RHIT-steineca/Armold/readme.md

If you are reading this then congrats you pulled the repo :D

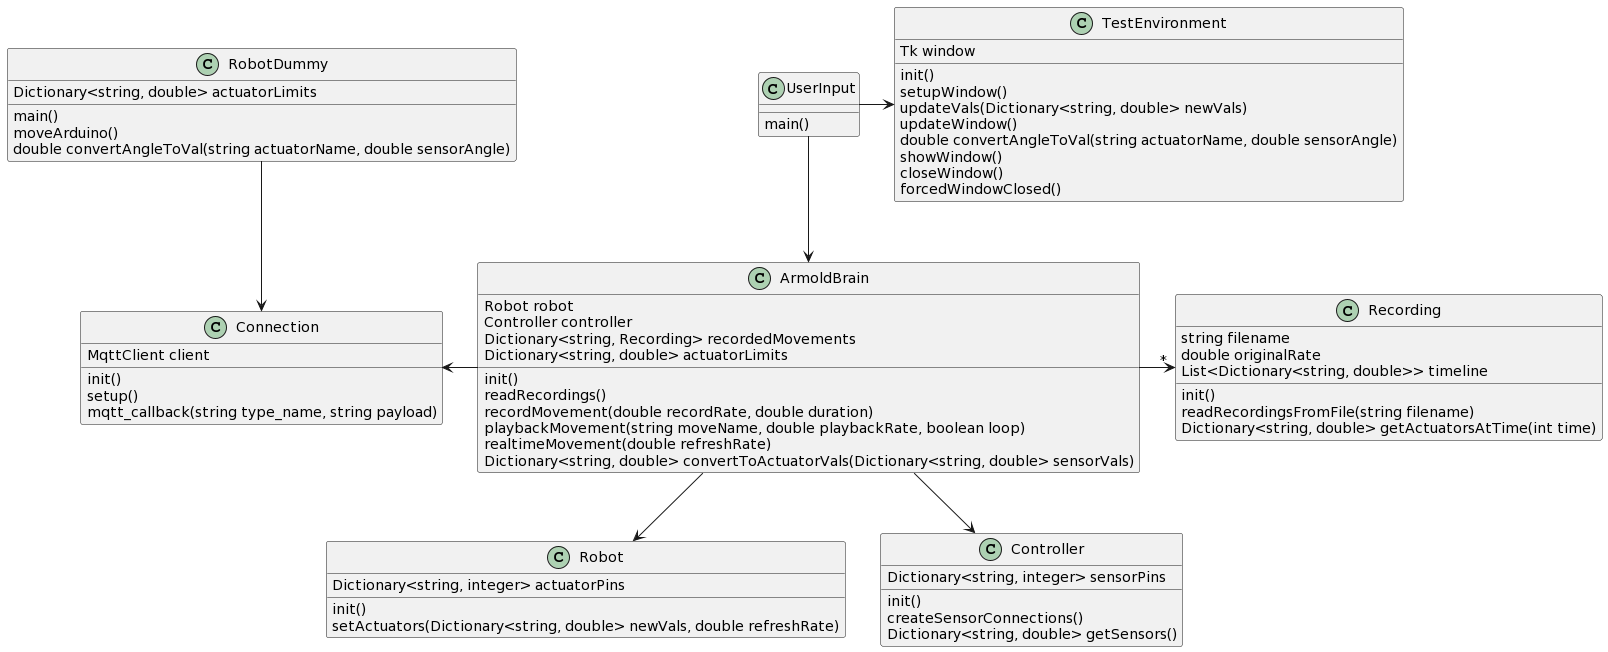
[picture p1: UML_diagram.png]
UML Diagram
