RHIT-steineca/Armold/Code_Files/pins.txt

Controller pins
{"shoulderCB":8,"shoulderLR":9,"elbow":10,"wrist":11,"fingerPTR":4,"fingerMDL":2,"fingerRNG":5,"fingerPKY":0,"fingerTHM":3,"shoulderR":12}
Robot pins
{"shoulderCB":12,"shoulderLR":13,"elbow":5,"wrist":6,"fingerPTR":11,"fingerMDL":10,"fingerRNG":8,"fingerPKY":7,"fingerTHM":9,"shoulderR":23}

NOTE: step direction pin is shoulderR - 1

full joint list for ez copying
{"shoulderCB":0,"shoulderLR":0,"elbow":0,"wrist":0,"fingerPTR":0,"fingerMDL":0,"fingerRNG":0,"fingerPKY":0,"fingerTHM":0,"shoulderR":0}
