RHIT-steineca/Armold/Important Documents/Current Budget.docx

Component | Max current draw (recorded) (A)
10K potentiometer | 0.077
Flex sensor | 0?
