RHIT-steineca/Armold/Important Documents/Servo Range of Motion.docx

Component | Restricted range | Max range | How much the part should move after the gears
Elbow | 0-235 | 0-270 | (18:12) 140 degrees
Pronation | 0-230 | 0-270 | (18:15) 180 degrees
Cross-body | 0-270 | 0-270 | (6:1) 45 degrees
Lateral | 0-270 | 0-270 | (3:1) 90 degrees
Stepper | 0-2400 | 0- | (12:1) 360 degrees
