RHIT-steineca/Armold/GearBox3DP0.png

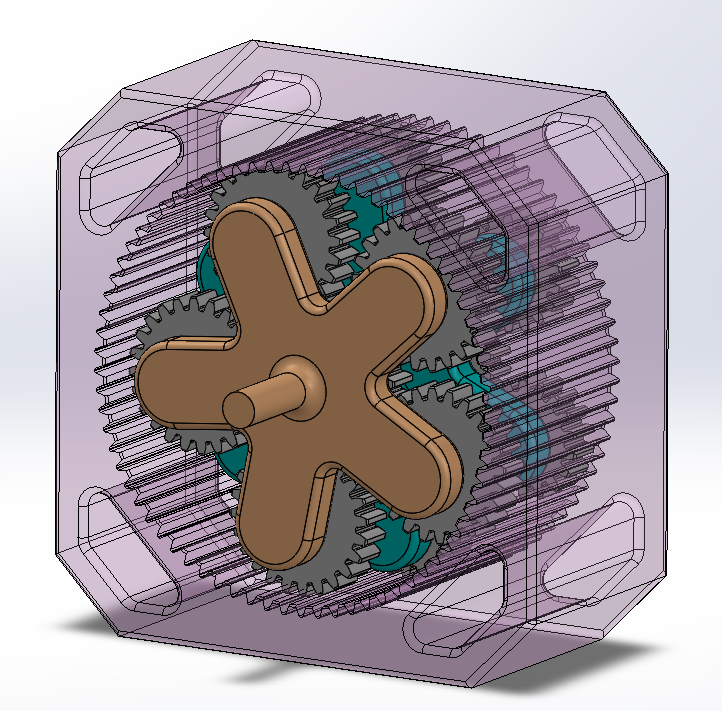
GearBox3DP0.png
