RHIT-steineca/Armold/Elbow and Pronation Solidworks/Elbow Assembly.SLDASM

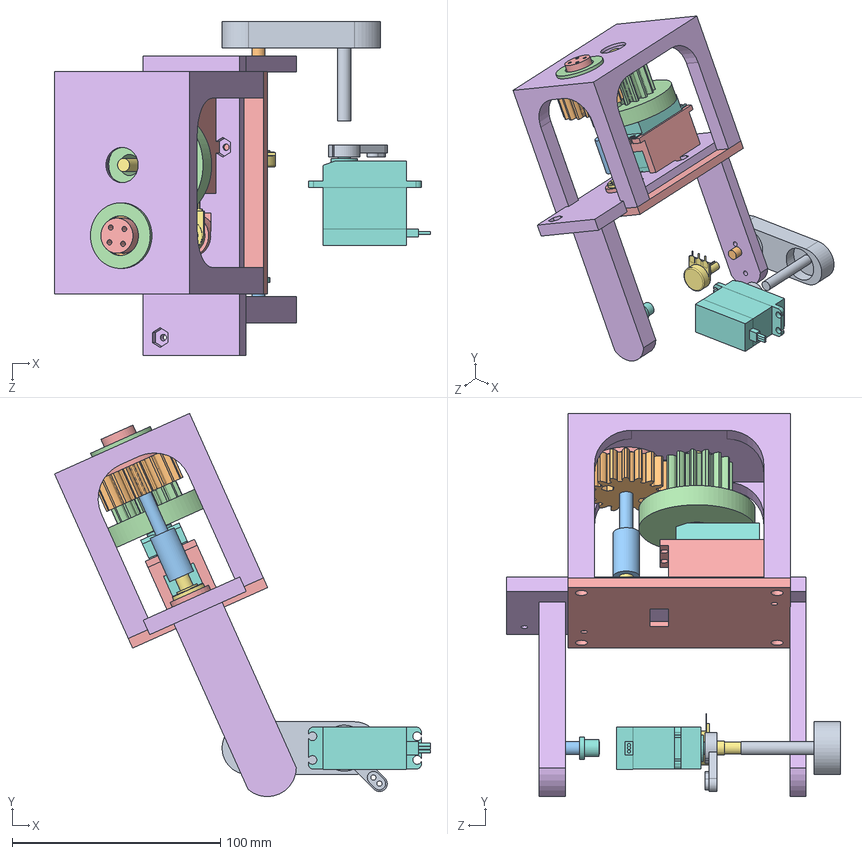
[picture p13: CAD file, 2024-05-17]
Elbow and Pronation Solidworks/Elbow Assembly.SLDASM
180.6 x 184.1 x 160.2 mm
B10K Potentiometer x 2
20KgServo x 2
20KgServoMetalElbow x 2
elbow to forearm connection
pronation base
24-15 Pronation Servo Gear
24-18 Pronation Potentiometer Gear
potentiometer to .25 stock
Needle Bearing x 2
bottom gear connection
Pronation top casing
Pronation Pot Stock
Pronation Servo Stock
Large Pronation Bearing
RodToBearingAdapter
Gear Connector
Elbow Servo stock
Elbow pronation stock
elbow rotation stock
