RHIT-steineca/Armold/Shared CAD/pronation top gears.SLDASM

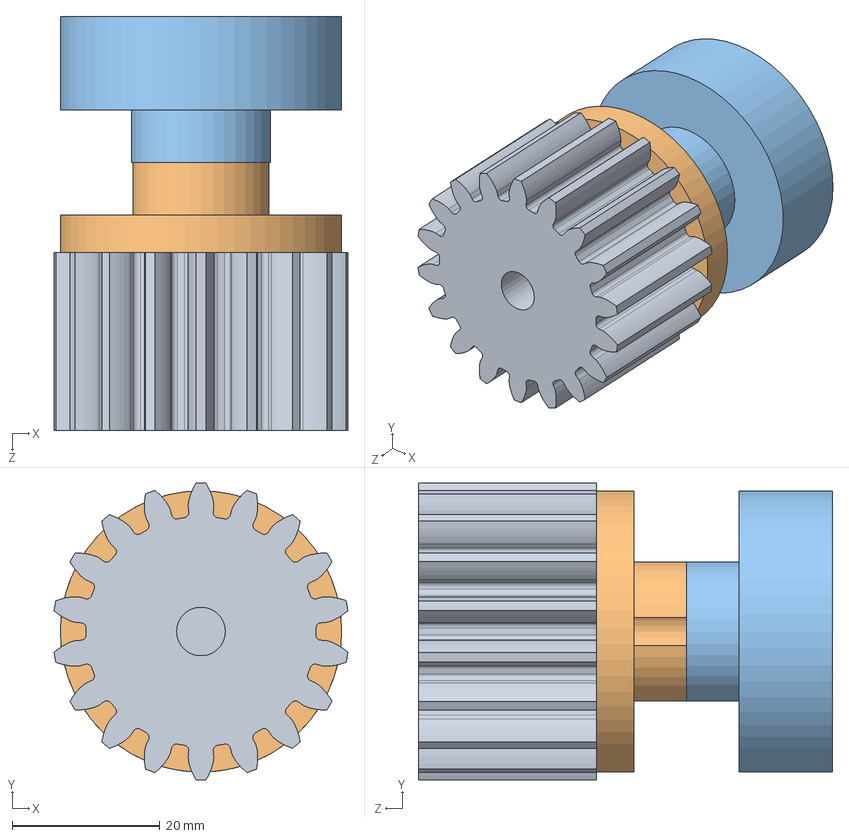
[picture p14: CAD file, 2024-01-10]
Shared CAD/pronation top gears.SLDASM
39.8 x 40.2 x 56.1 mm
24-18 Pronation Potentiometer Gear
bottom gear connection
top gear connection
