RHIT-steineca/Armold/Shared CAD/Elbow Assembly.SLDASM

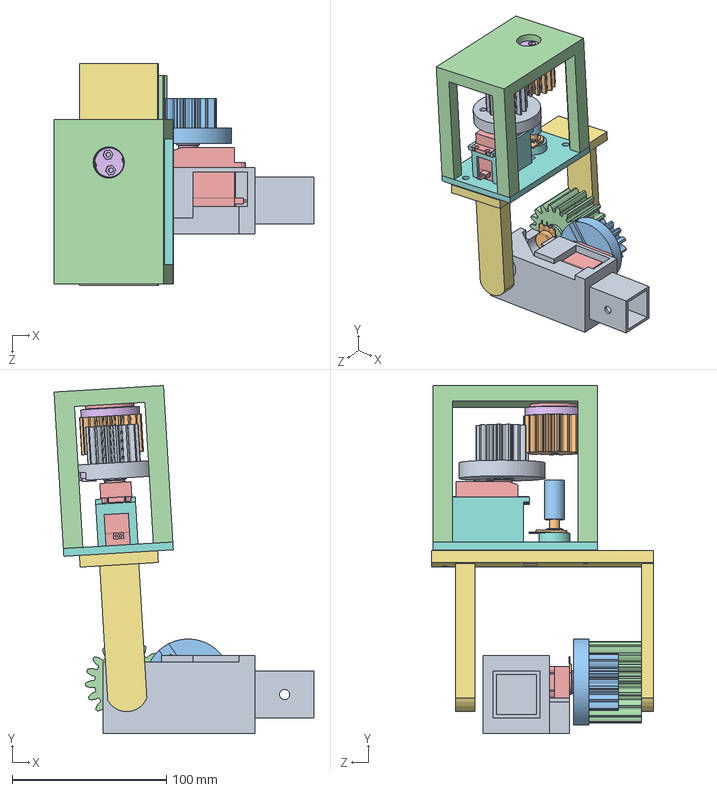
[picture p15: CAD file, 2024-01-10]
Shared CAD/Elbow Assembly.SLDASM
168.5 x 225.6 x 143.7 mm
ServoHolderElbow
B10K Potentiometer x 2
24 pitch 12 teeth 2.5x scale
24 pitch 18 teeth
20KgServo x 2
20KgServoMetalElbow x 2
elbow to forearm connection
pronation base
24-15 Pronation Servo Gear
24-18 Pronation Potentiometer Gear
potentiometer to .25 stock
Pronation top casing
Needle Bearing
bottom gear connection
