RHIT-steineca/Armold/Elbow and Pronation Solidworks/Pronation Assembly.SLDASM

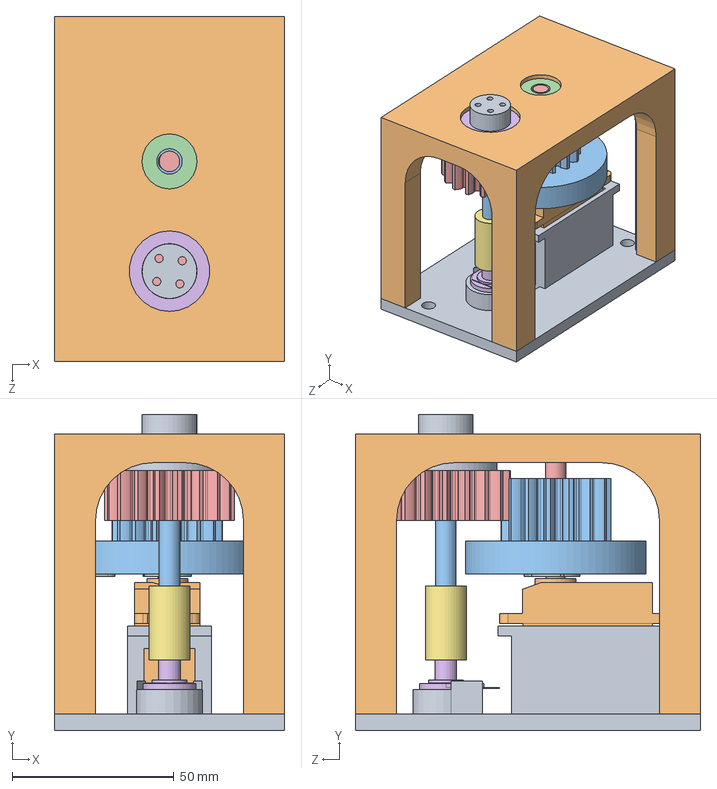
[picture p16: CAD file, 2024-03-17]
Elbow and Pronation Solidworks/Pronation Assembly.SLDASM
71.1 x 97.7 x 106.7 mm
pronation base
20KgServo
24-15 Pronation Servo Gear
20KgServoMetalElbow
24-18 Pronation Potentiometer Gear
B10K Potentiometer
potentiometer to .25 stock
Needle Bearing
bottom gear connection
Pronation top casing
Pronation Pot Stock
Basic Roller Bearing
Pronation Servo Stock
Large Pronation Bearing
