RHIT-steineca/Armold/Control Panel/perfboard holder.SLDPRT

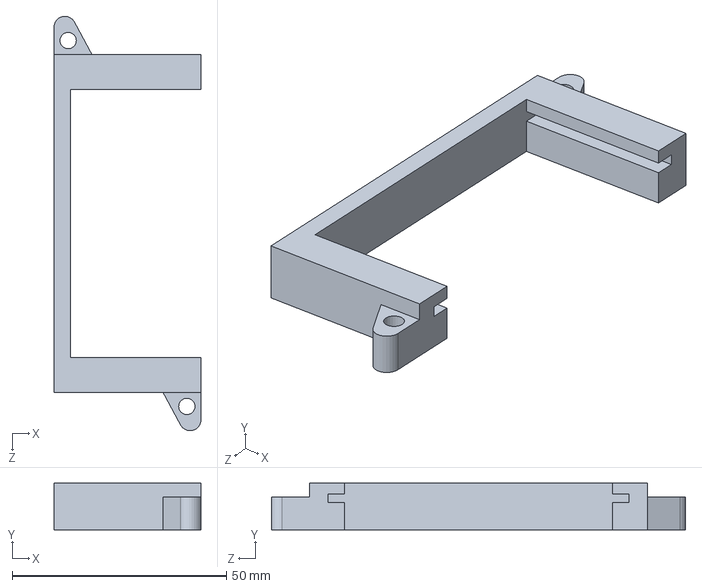
[picture p17: CAD file, 2024-05-18]
Control Panel/perfboard holder.SLDPRT
34.3 x 10.9 x 96.6 mm
