RHIT-steineca/Armold/Design_Files/Elbow Form 1.STL

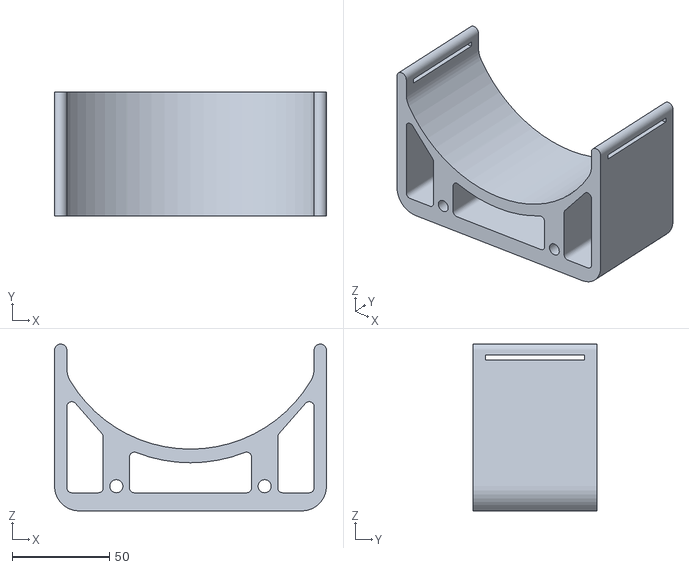
[picture p18: CAD file, 2023-09-13]
Design_Files/Elbow Form 1.STL
139.7 x 63.5 x 85.7
