RHIT-steineca/Armold/Hand and Forearm Solidworks/tensioner.SLDPRT

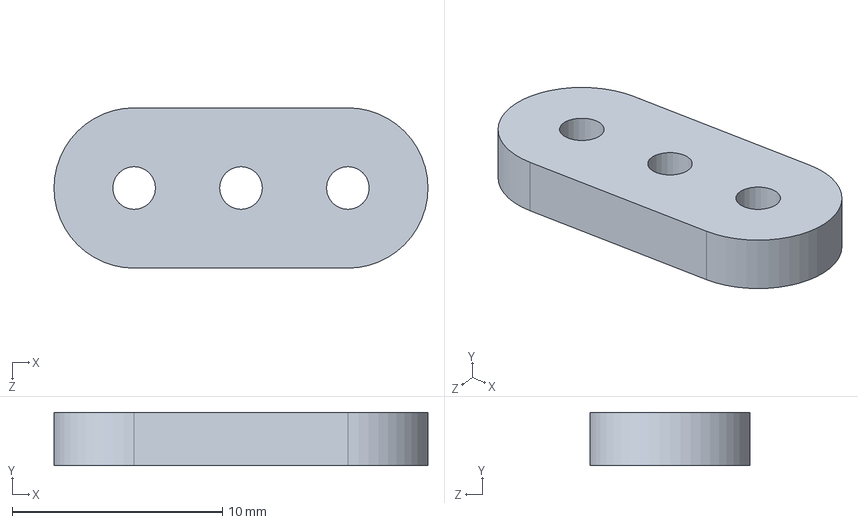
[picture p19: CAD file, 2024-05-18]
Hand and Forearm Solidworks/tensioner.SLDPRT
17.8 x 2.54 x 7.62 mm
