RHIT-steineca/Armold/Shared CAD/top gear connection.SLDPRT

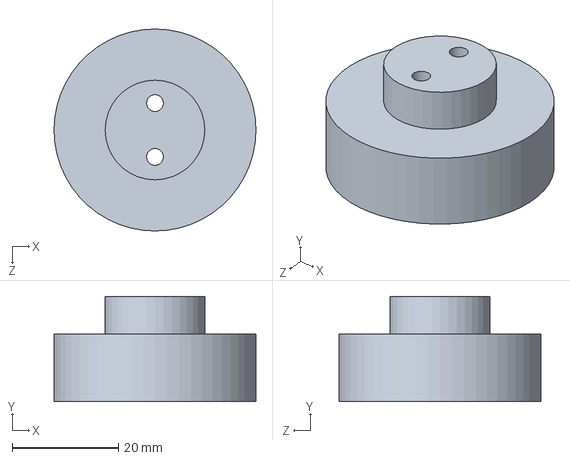
[picture p20: CAD file, 2024-05-18]
Shared CAD/top gear connection.SLDPRT
38.1 x 19.8 x 38.1 mm
