RHIT-steineca/Armold/Design_Files/Wrist Form 2.STL

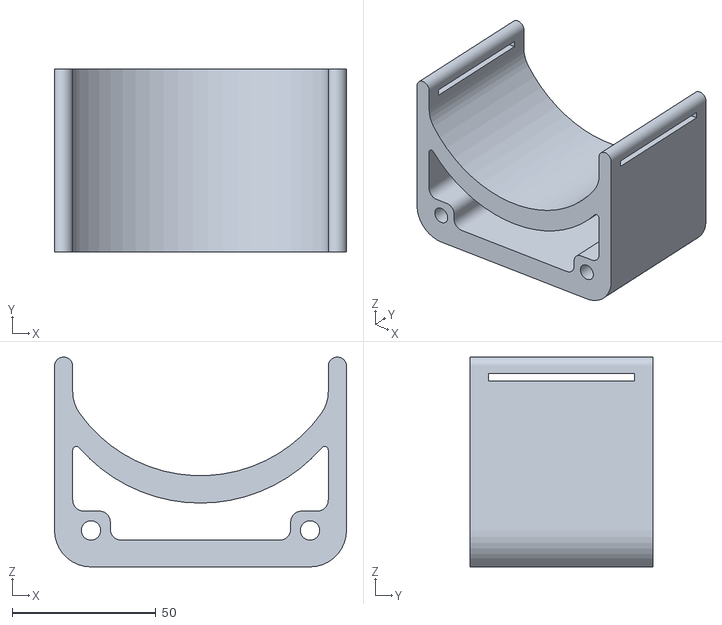
[picture p21: CAD file, 2023-09-13]
Design_Files/Wrist Form 2.STL
101.6 x 63.5 x 73.0
