RHIT-steineca/Armold/Hand and Forearm Solidworks/spool.SLDPRT

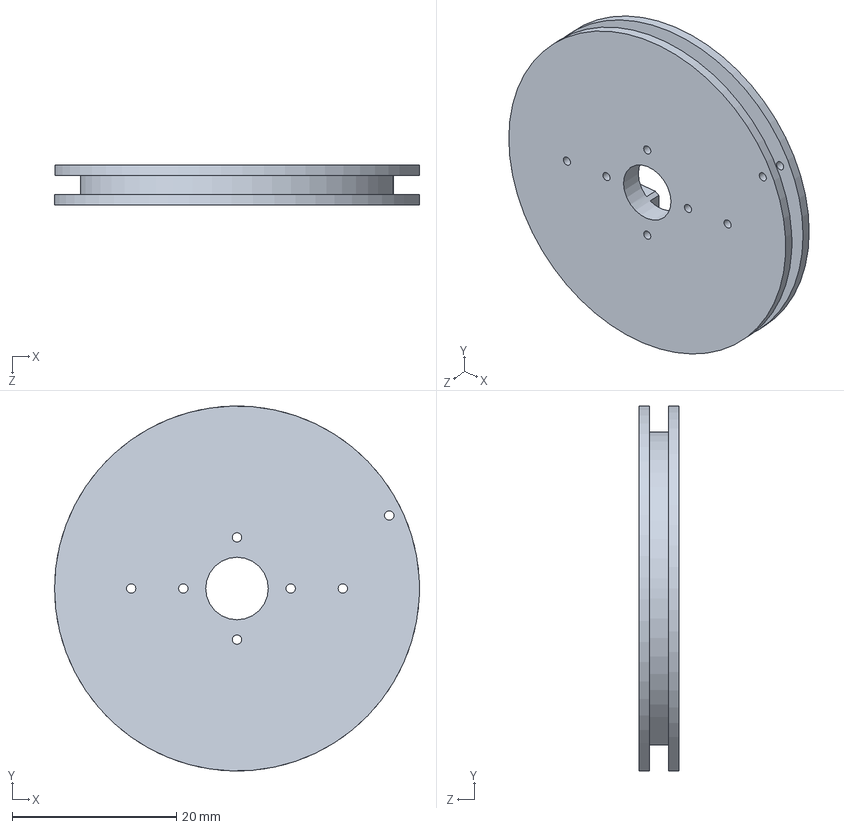
[picture p22: CAD file, 2024-05-18]
Hand and Forearm Solidworks/spool.SLDPRT
44.5 x 44.4 x 4.83 mm
