RHIT-steineca/Armold/Shared CAD/elbow to forearm connection.SLDPRT

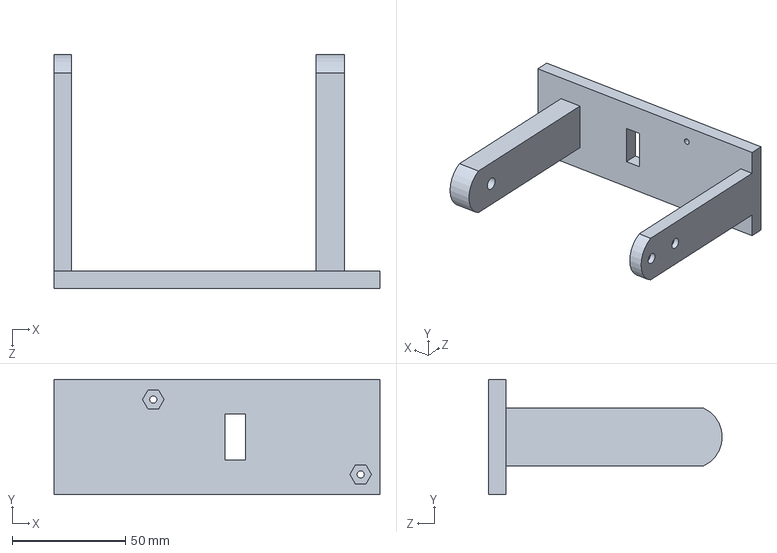
[picture p23: CAD file, 2024-01-10]
Shared CAD/elbow to forearm connection.SLDPRT
143.7 x 50.8 x 102.9 mm
