RHIT-steineca/Armold/Design_Files/Wrist Form 1.STL

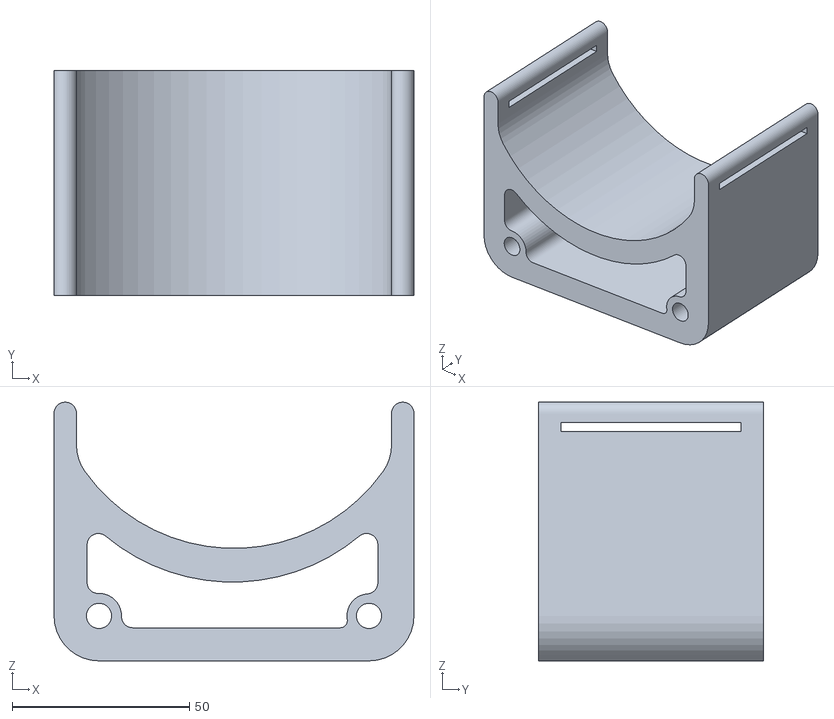
[picture p24: CAD file, 2023-09-13]
Design_Files/Wrist Form 1.STL
101.6 x 63.5 x 73.0
