RHIT-steineca/Armold/Elbow and Pronation Solidworks/elbow to forearm connection.SLDPRT

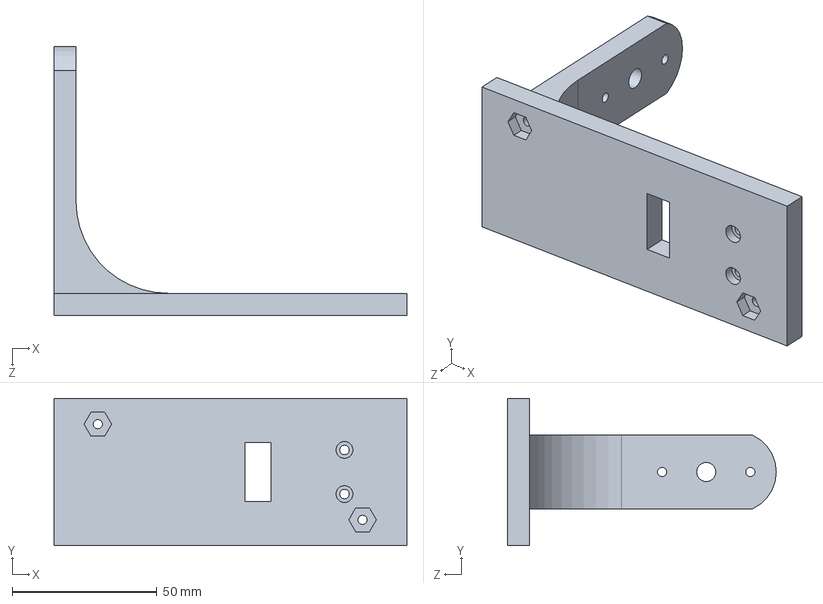
[picture p25: CAD file, 2024-03-17]
Elbow and Pronation Solidworks/elbow to forearm connection.SLDPRT
121.9 x 50.8 x 92.8 mm
