RHIT-steineca/Armold/Shared CAD/24 pitch 12 teeth 2.5x scale.SLDPRT

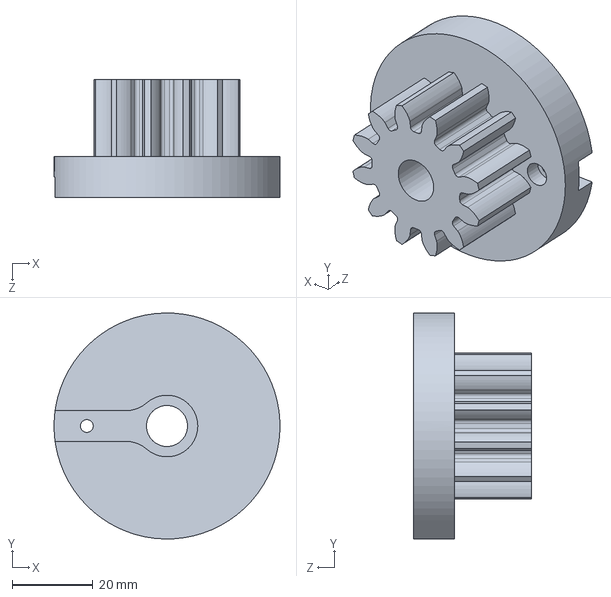
[picture p26: CAD file, 2024-01-10]
Shared CAD/24 pitch 12 teeth 2.5x scale.SLDPRT
55.9 x 55.9 x 29.2 mm
