RHIT-steineca/Armold/Elbow and Pronation Solidworks/upper arm stock.SLDPRT

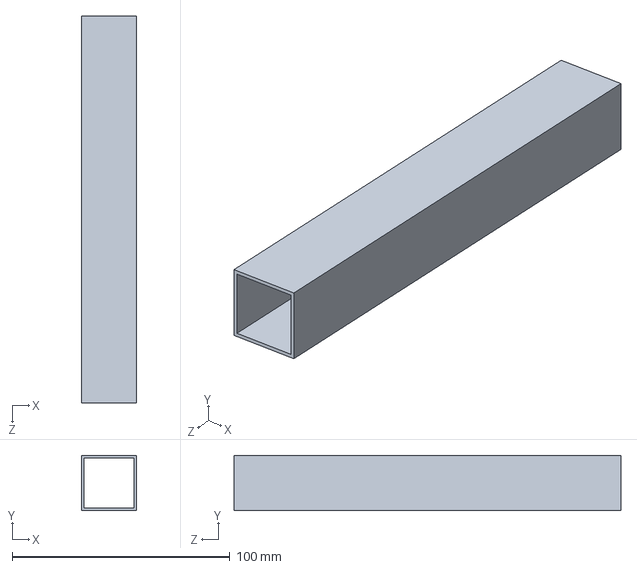
[picture p27: CAD file, 2024-03-17]
Elbow and Pronation Solidworks/upper arm stock.SLDPRT
25.4 x 25.4 x 177.8 mm
