RHIT-steineca/Armold/Shared CAD/24 pitch 18 teeth.SLDPRT

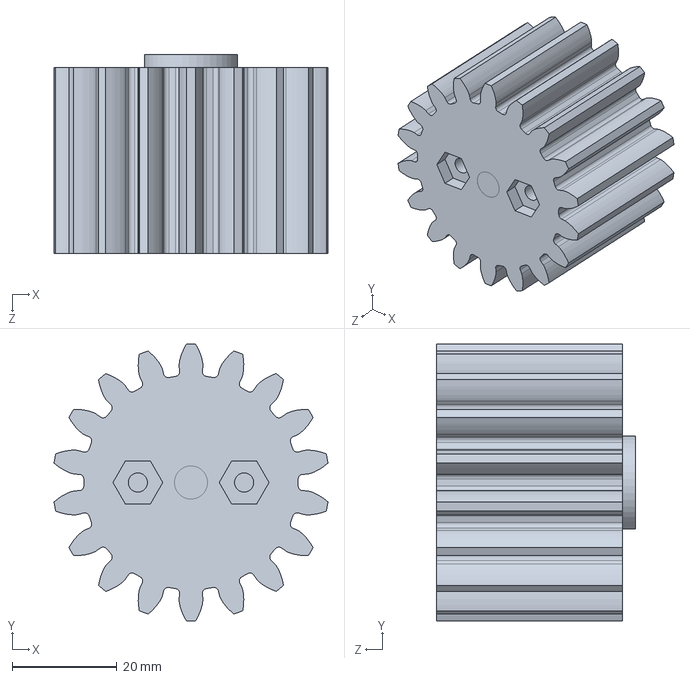
[picture p28: CAD file, 2024-01-10]
Shared CAD/24 pitch 18 teeth.SLDPRT
52.4 x 52.9 x 38.1 mm
