RHIT-steineca/Armold/Elbow and Pronation Solidworks/ServoHolder.SLDPRT

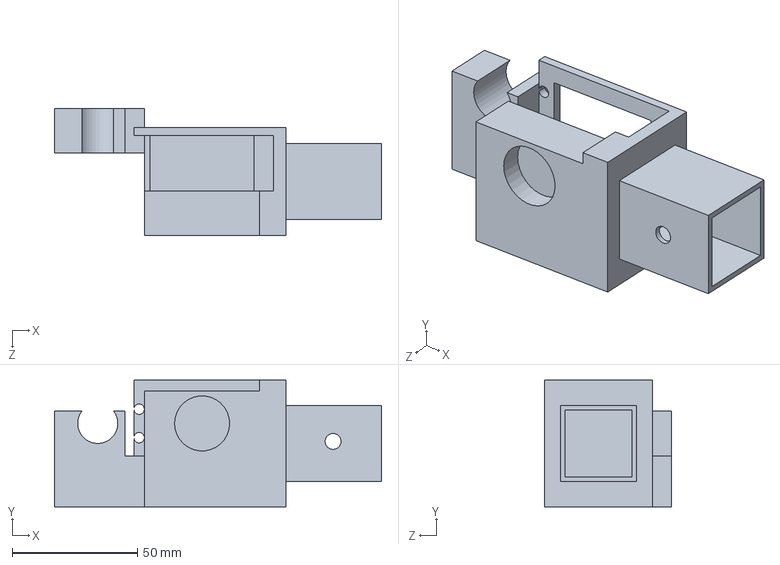
[picture p29: CAD file, 2024-03-17]
Elbow and Pronation Solidworks/ServoHolder.SLDPRT
130.6 x 50.5 x 50.8 mm
