RHIT-steineca/Armold/Shared CAD/bottom gear connection.SLDPRT

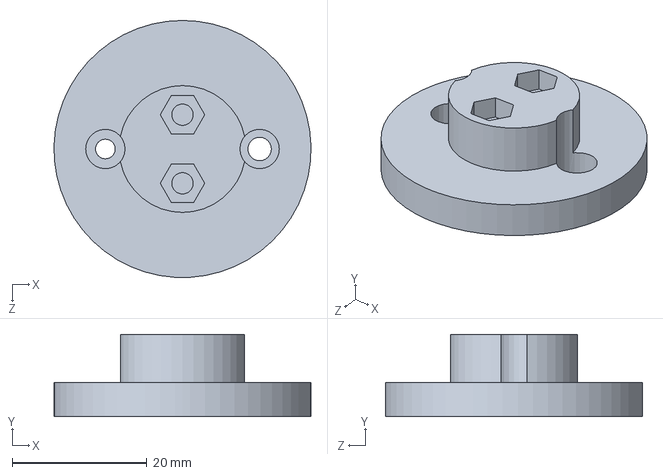
[picture p30: CAD file, 2024-01-10]
Shared CAD/bottom gear connection.SLDPRT
38.1 x 12.2 x 38.1 mm
