RHIT-steineca/Armold/Elbow and Pronation Solidworks/top gear connection.SLDPRT

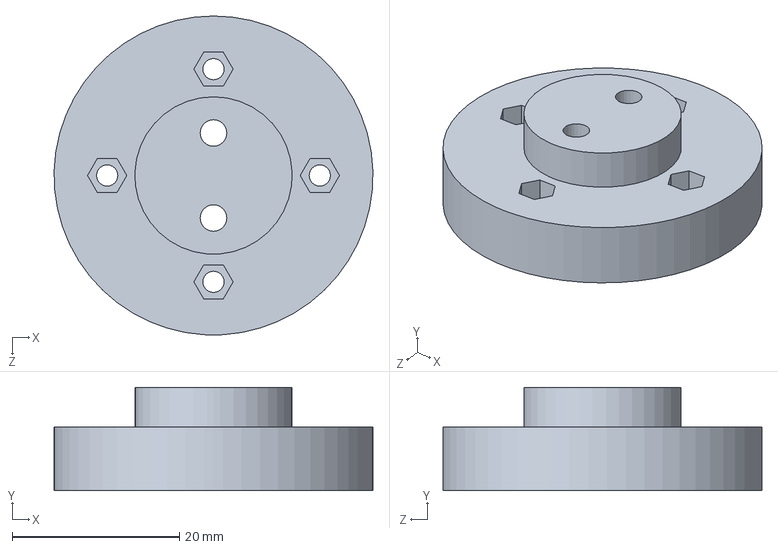
[picture p31: CAD file, 2024-03-17]
Elbow and Pronation Solidworks/top gear connection.SLDPRT
38.1 x 12.3 x 38.1 mm
