RHIT-steineca/Armold/Shared CAD/RodToBearingAdapter.SLDPRT

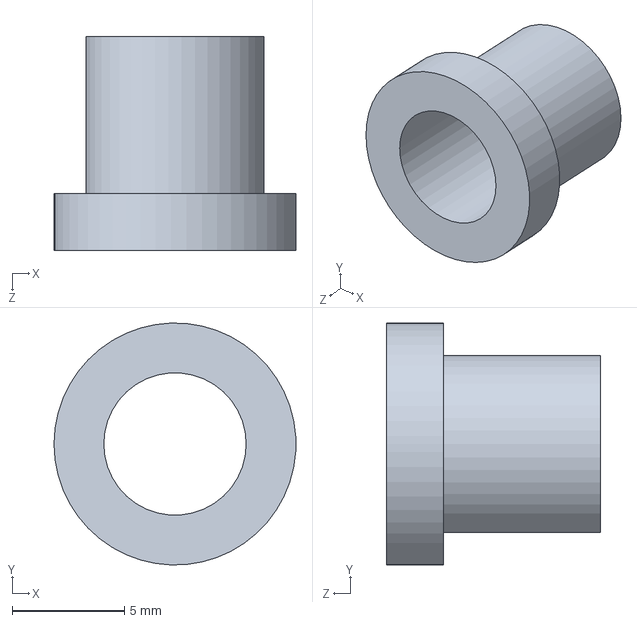
[picture p32: CAD file, 2024-01-10]
Shared CAD/RodToBearingAdapter.SLDPRT
10.8 x 10.8 x 9.54 mm
