RHIT-steineca/Armold/Elbow and Pronation Solidworks/Elbow pronation stock.SLDPRT

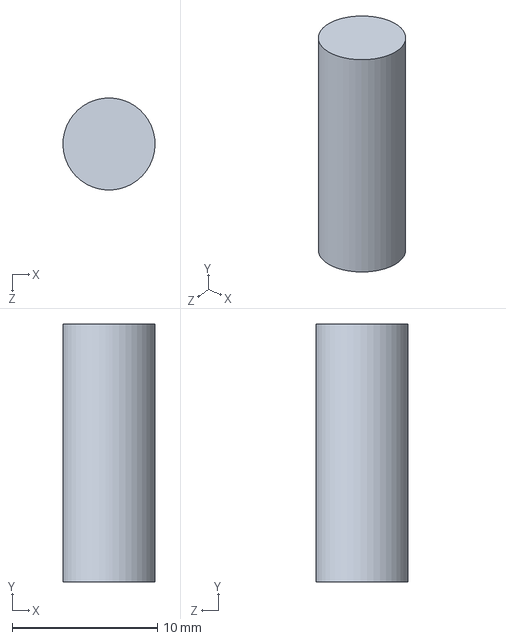
[picture p33: CAD file, 2024-03-17]
Elbow and Pronation Solidworks/Elbow pronation stock.SLDPRT
6.35 x 17.8 x 6.35 mm
