RHIT-steineca/Armold/Shared CAD/24-15 Pronation Servo Gear.SLDPRT

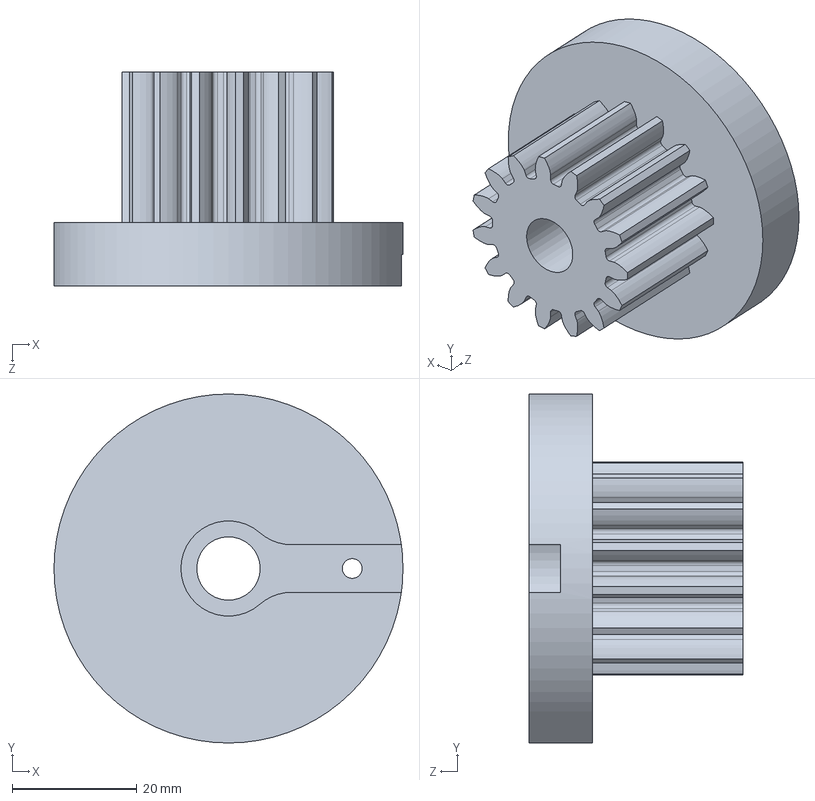
[picture p34: CAD file, 2024-01-10]
Shared CAD/24-15 Pronation Servo Gear.SLDPRT
55.9 x 55.9 x 34.3 mm
