RHIT-steineca/Armold/Elbow and Pronation Solidworks/Pronation top casing.SLDPRT

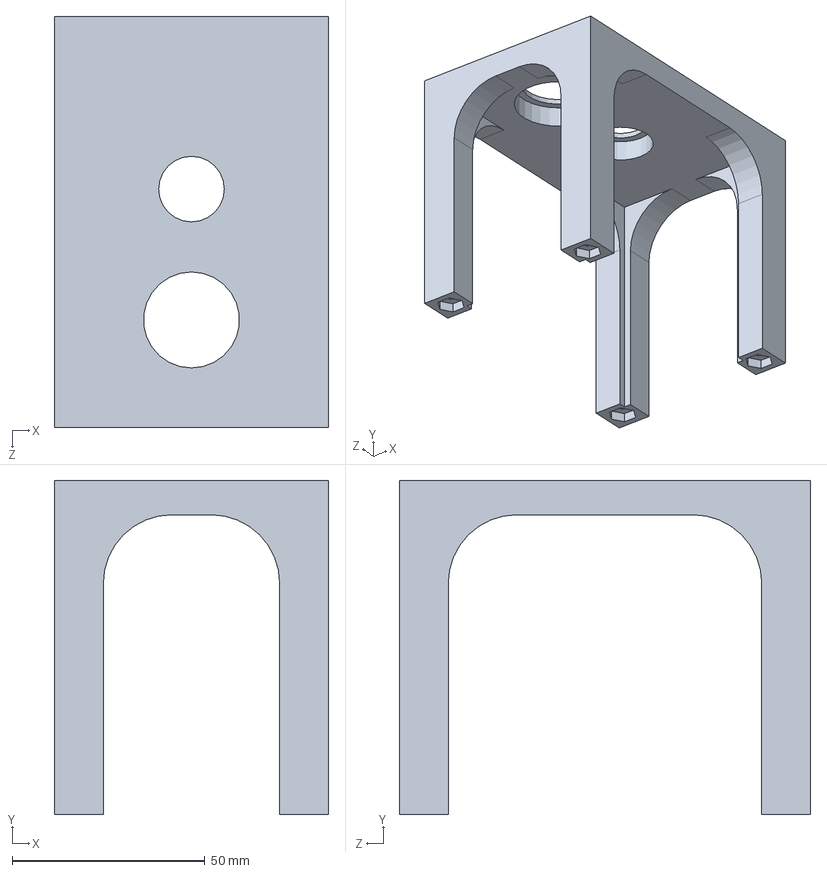
[picture p35: CAD file, 2024-03-17]
Elbow and Pronation Solidworks/Pronation top casing.SLDPRT
71.1 x 86.6 x 106.7 mm
