RHIT-steineca/Armold/Shared CAD/Pronation top casing.SLDPRT

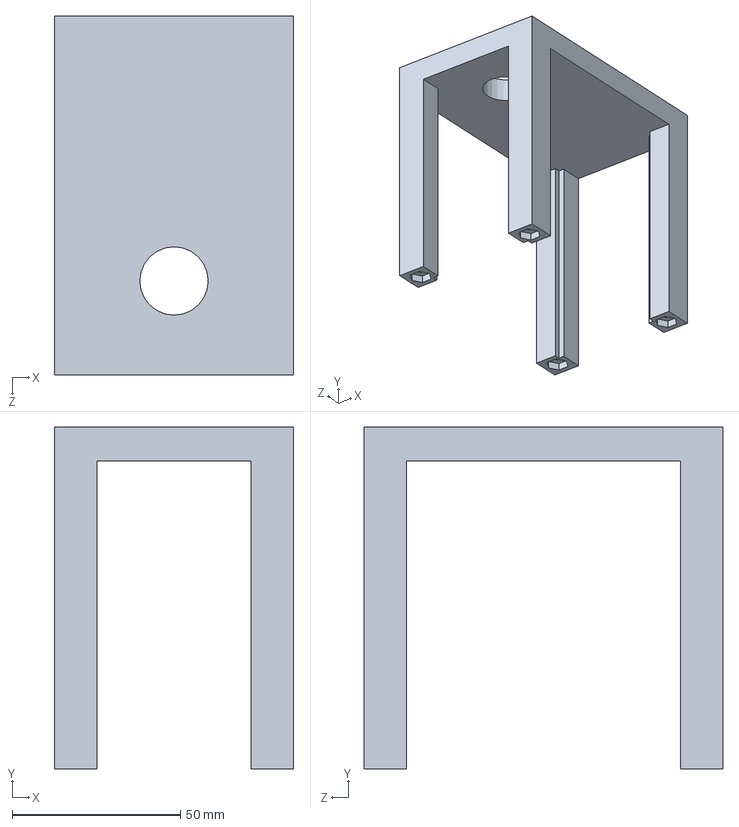
[picture p36: CAD file, 2024-01-10]
Shared CAD/Pronation top casing.SLDPRT
71.1 x 101.6 x 106.7 mm
