RHIT-steineca/Armold/Elbow and Pronation Solidworks/24-18 Pronation Potentiometer Gear.SLDPRT

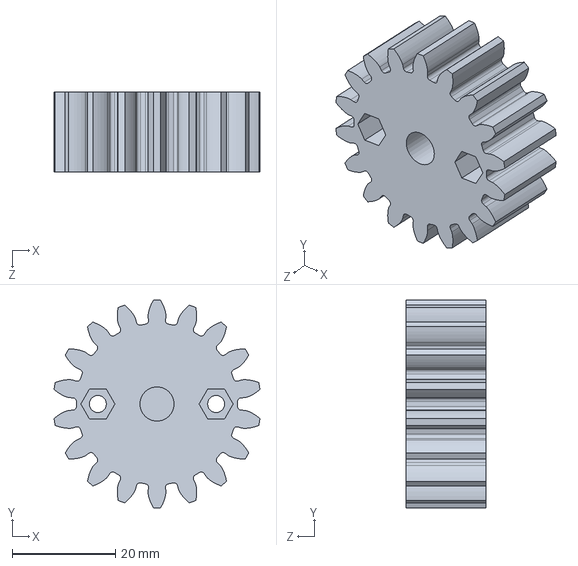
[picture p37: CAD file, 2024-03-17]
Elbow and Pronation Solidworks/24-18 Pronation Potentiometer Gear.SLDPRT
39.8 x 40.2 x 15.5 mm
