RHIT-steineca/Armold/Elbow and Pronation Solidworks/Gear Connector.SLDPRT

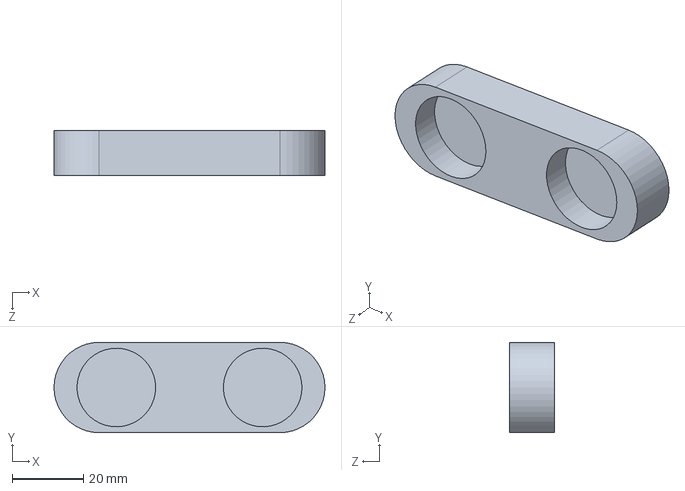
[picture p38: CAD file, 2024-03-17]
Elbow and Pronation Solidworks/Gear Connector.SLDPRT
76.2 x 25.4 x 12.7 mm
