RHIT-steineca/Armold/Shared CAD/potentiometer to .25 stock.SLDPRT

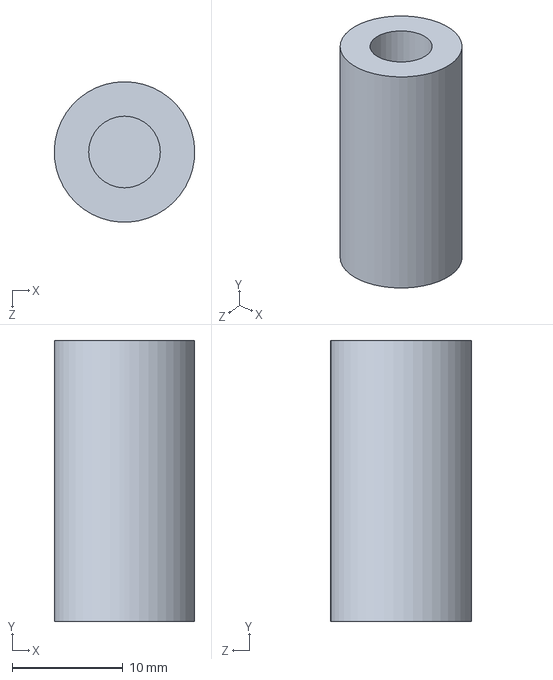
[picture p39: CAD file, 2024-01-10]
Shared CAD/potentiometer to .25 stock.SLDPRT
12.7 x 25.4 x 12.7 mm
