RHIT-steineca/Armold/Elbow and Pronation Solidworks/RodToBearingAdapter.SLDPRT

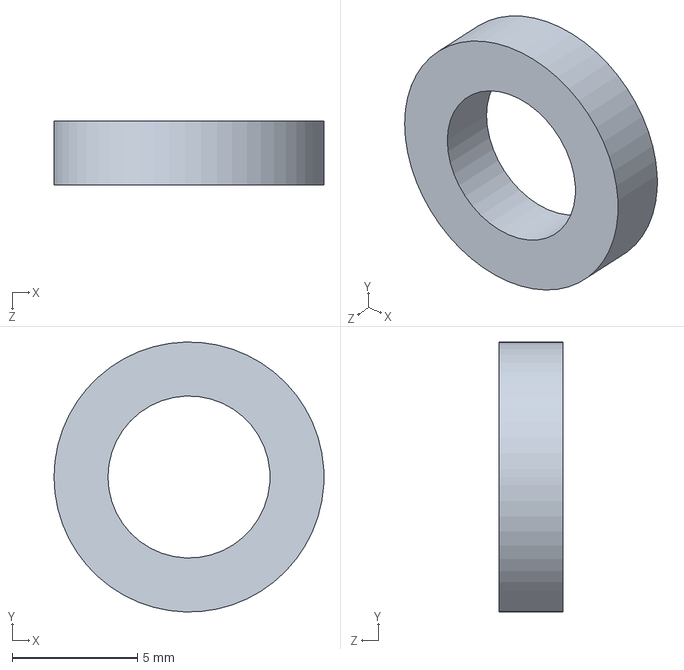
[picture p40: CAD file, 2024-03-17]
Elbow and Pronation Solidworks/RodToBearingAdapter.SLDPRT
10.8 x 10.8 x 2.54 mm
