RHIT-steineca/Armold/Elbow and Pronation Solidworks/FidgetSpinnerBearing.SLDPRT

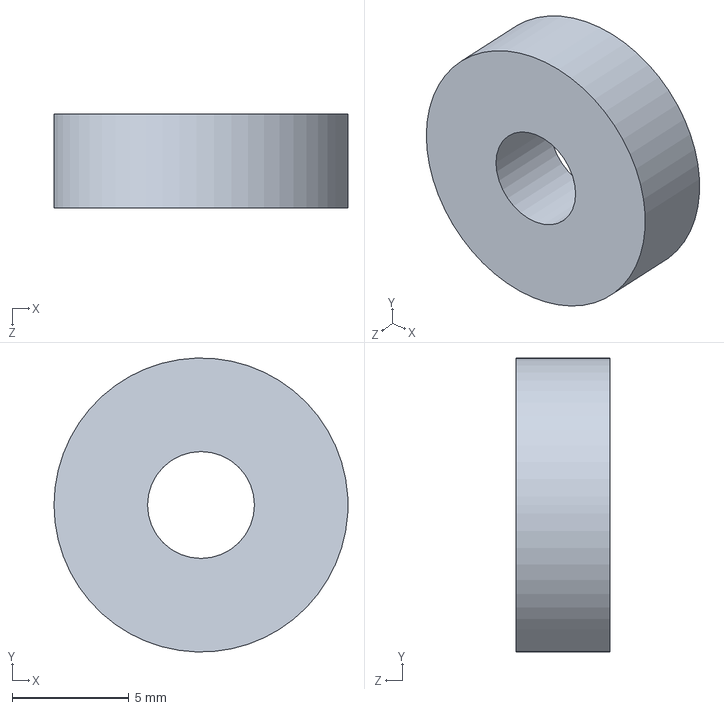
[picture p41: CAD file, 2024-03-17]
Elbow and Pronation Solidworks/FidgetSpinnerBearing.SLDPRT
12.6 x 12.6 x 4.00 mm
