RHIT-steineca/Armold/Shared CAD/24-18 Pronation Potentiometer Gear.SLDPRT

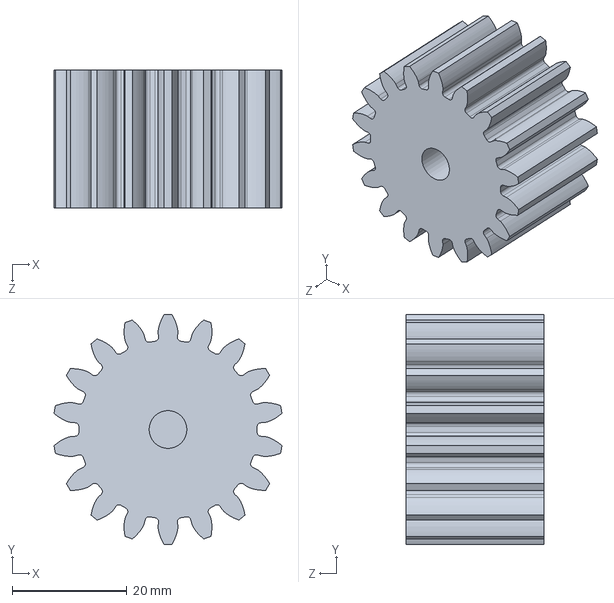
[picture p42: CAD file, 2024-01-10]
Shared CAD/24-18 Pronation Potentiometer Gear.SLDPRT
39.8 x 40.2 x 24.1 mm
