RHIT-steineca/Armold/Elbow and Pronation Solidworks/Large Pronation Bearing.SLDPRT

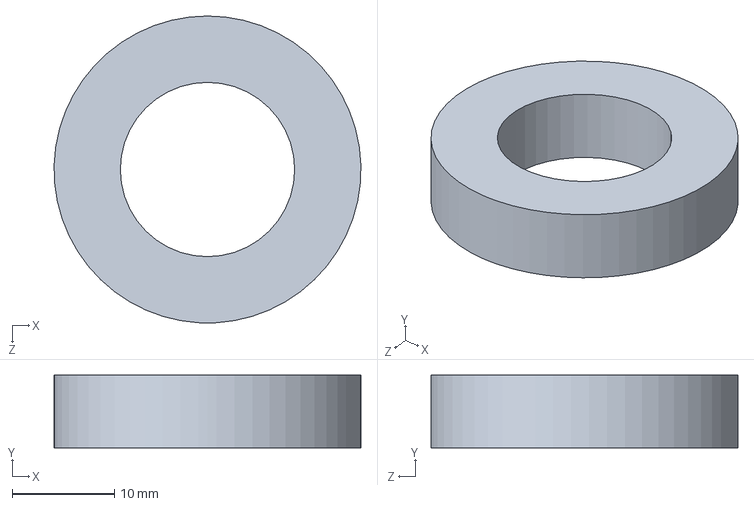
[picture p43: CAD file, 2024-03-17]
Elbow and Pronation Solidworks/Large Pronation Bearing.SLDPRT
30.0 x 7.11 x 30.0 mm
