RHIT-steineca/Armold/Shared CAD/pronation base.SLDPRT

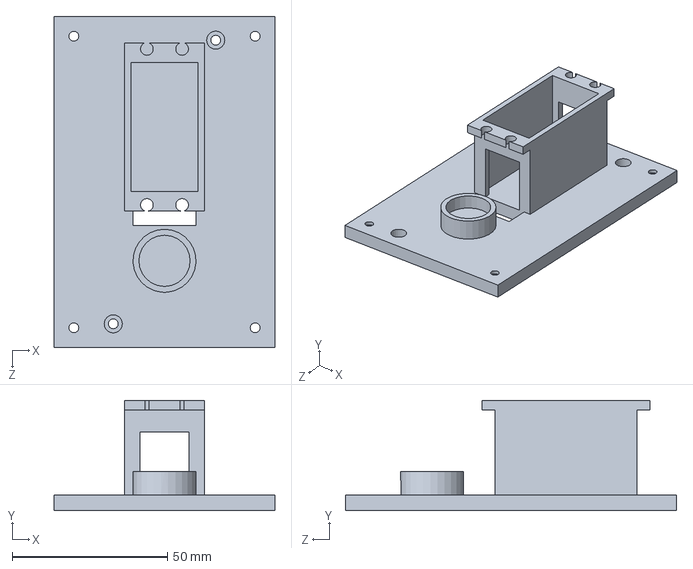
[picture p44: CAD file, 2024-01-10]
Shared CAD/pronation base.SLDPRT
71.1 x 35.6 x 106.7 mm
