RHIT-steineca/Armold/Elbow and Pronation Solidworks/bottom gear connection.SLDPRT

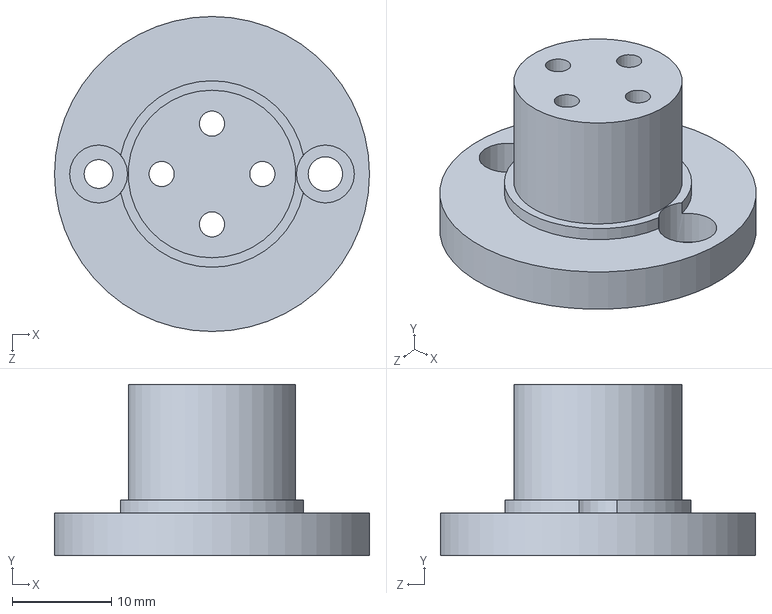
[picture p45: CAD file, 2024-03-17]
Elbow and Pronation Solidworks/bottom gear connection.SLDPRT
31.8 x 17.3 x 31.8 mm
