RHIT-steineca/Armold/Elbow and Pronation Solidworks/Elbow Servo stock.SLDPRT

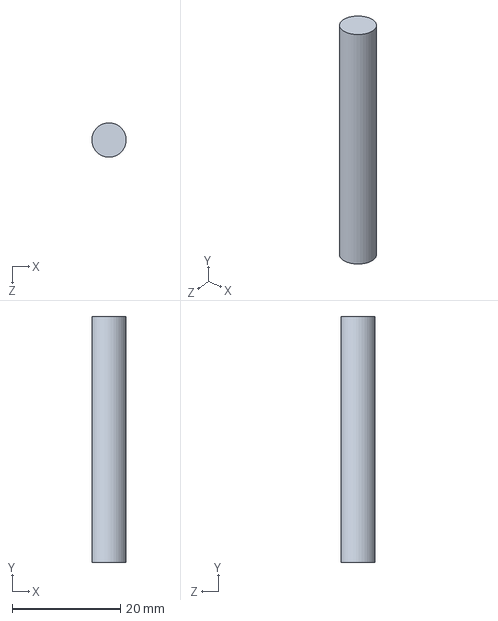
[picture p46: CAD file, 2024-03-17]
Elbow and Pronation Solidworks/Elbow Servo stock.SLDPRT
6.34 x 45.4 x 6.35 mm
