RHIT-steineca/Armold/Shared CAD/24 pitch 12 teeth 2x scale v1.SLDPRT

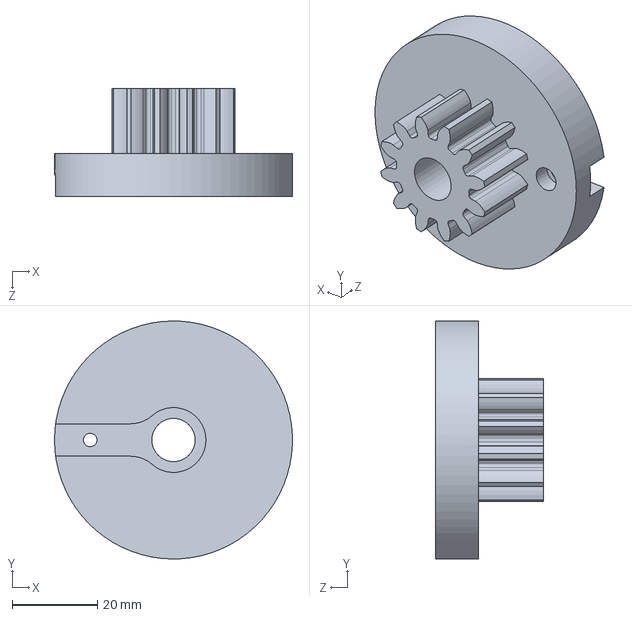
[picture p47: CAD file, 2023-12-11]
Shared CAD/24 pitch 12 teeth 2x scale v1.SLDPRT
55.9 x 55.9 x 25.4 mm
