RHIT-steineca/Armold/Elbow and Pronation Solidworks/pronation base.SLDPRT

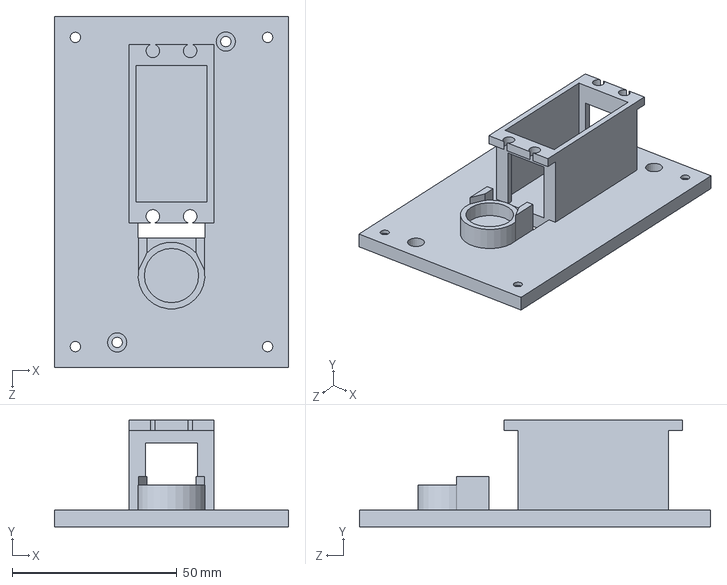
[picture p48: CAD file, 2024-03-17]
Elbow and Pronation Solidworks/pronation base.SLDPRT
71.1 x 32.4 x 106.7 mm
