RHIT-steineca/Armold/Shared CAD/Rotary Encoder Sunfounder.SLDPRT

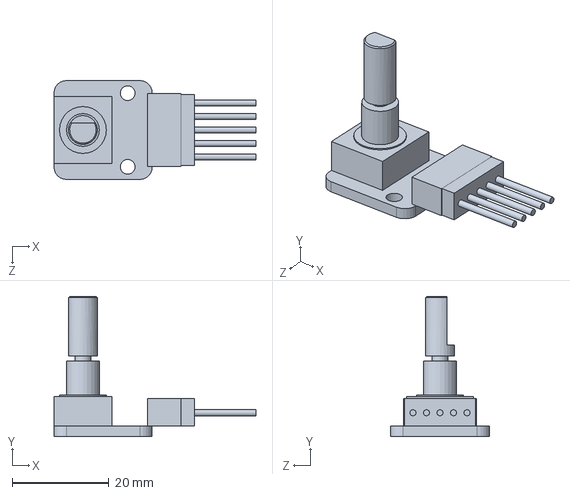
[picture p49: CAD file, 2023-11-29]
Shared CAD/Rotary Encoder Sunfounder.SLDPRT
41.8 x 29.0 x 20.4 mm
