RHIT-steineca/Armold/Elbow and Pronation Solidworks/Pronation Pot Stock.SLDPRT

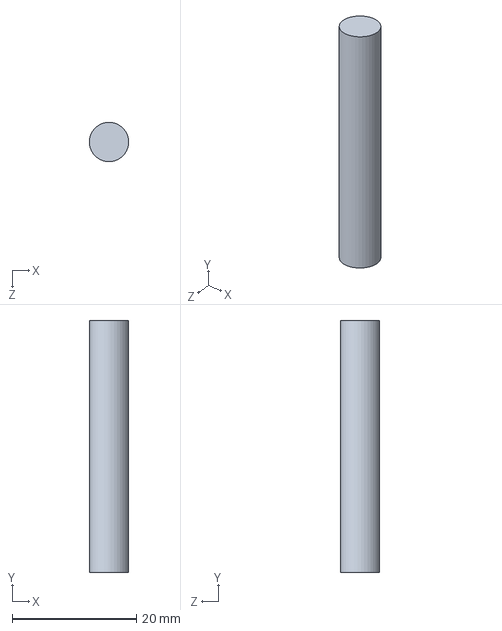
[picture p50: CAD file, 2024-03-17]
Elbow and Pronation Solidworks/Pronation Pot Stock.SLDPRT
6.34 x 40.6 x 6.35 mm
