RHIT-steineca/Armold/Shared CAD/ServoHolder.SLDPRT

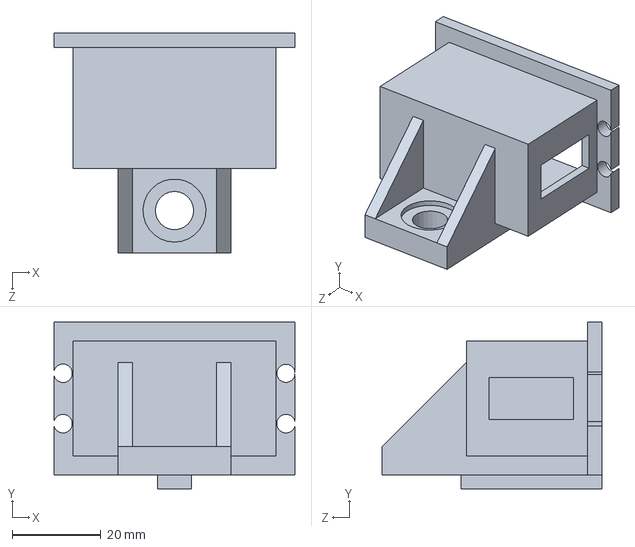
[picture p51: CAD file, 2023-11-29]
Shared CAD/ServoHolder.SLDPRT
54.4 x 37.6 x 49.5 mm
