RHIT-steineca/Armold/Elbow and Pronation Solidworks/potentiometer to .25 stock.SLDPRT

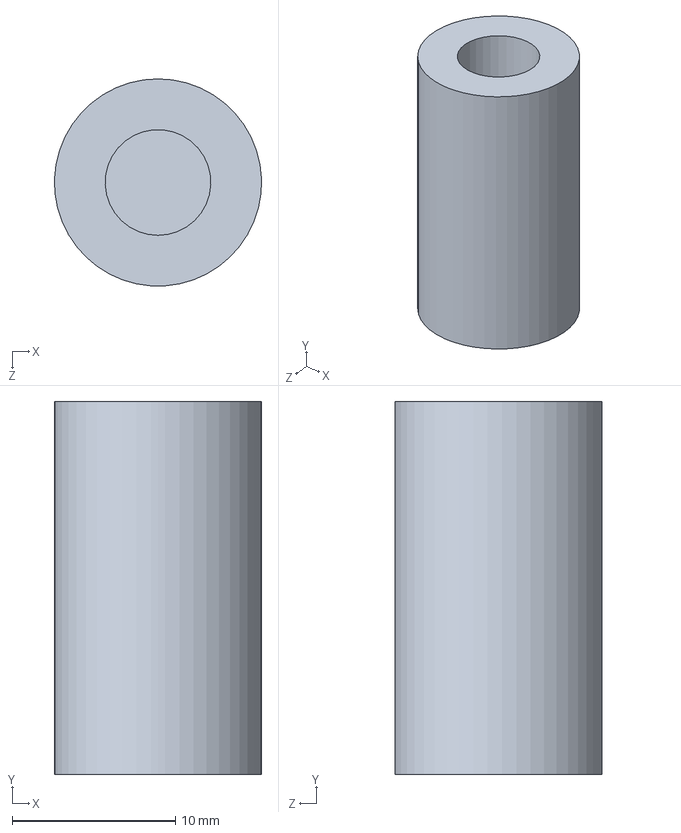
[picture p52: CAD file, 2024-03-17]
Elbow and Pronation Solidworks/potentiometer to .25 stock.SLDPRT
12.7 x 22.9 x 12.7 mm
