RHIT-steineca/Armold/Shared CAD/PlanetPitch24N18V4Scaled.SLDPRT

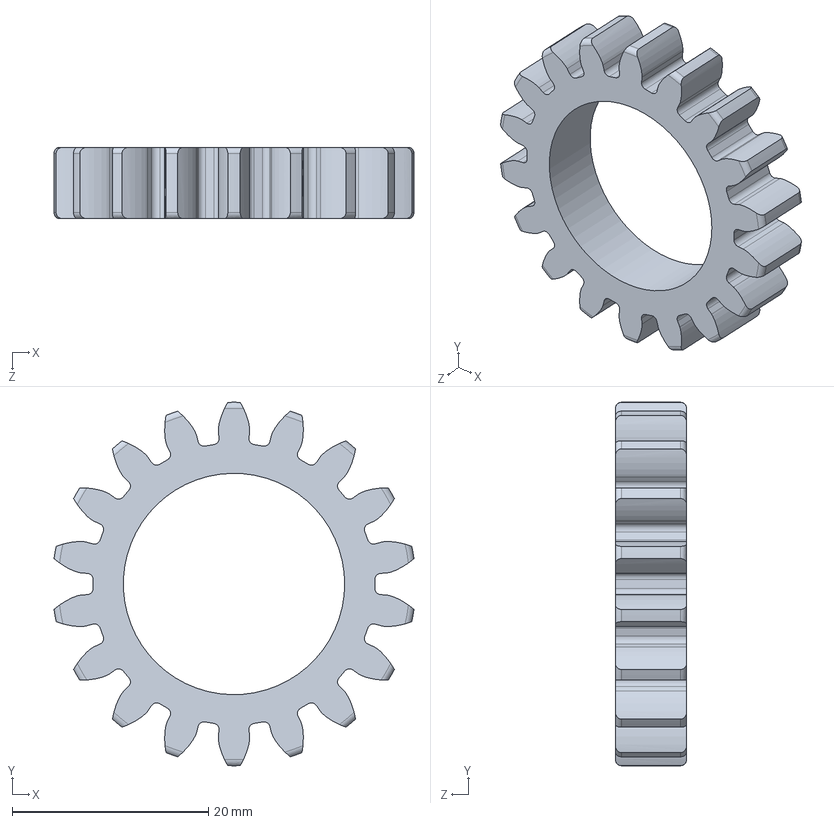
[picture p53: CAD file, 2023-10-04]
Shared CAD/PlanetPitch24N18V4Scaled.SLDPRT
36.7 x 37.0 x 7.26 mm
