RHIT-steineca/Armold/Elbow and Pronation Solidworks/24 pitch 18 teeth.SLDPRT

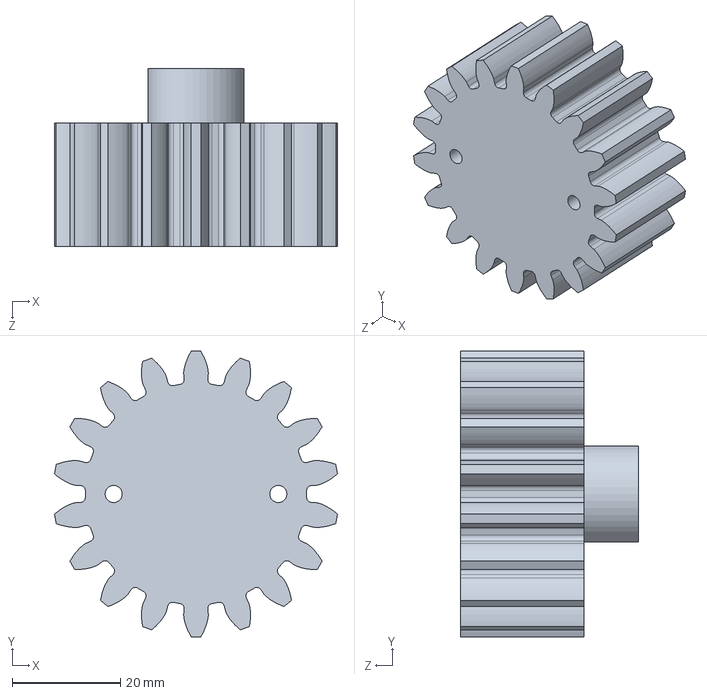
[picture p54: CAD file, 2024-03-17]
Elbow and Pronation Solidworks/24 pitch 18 teeth.SLDPRT
52.4 x 52.9 x 33.0 mm
