RHIT-steineca/Armold/Shared CAD/Roller Bearing.SLDPRT

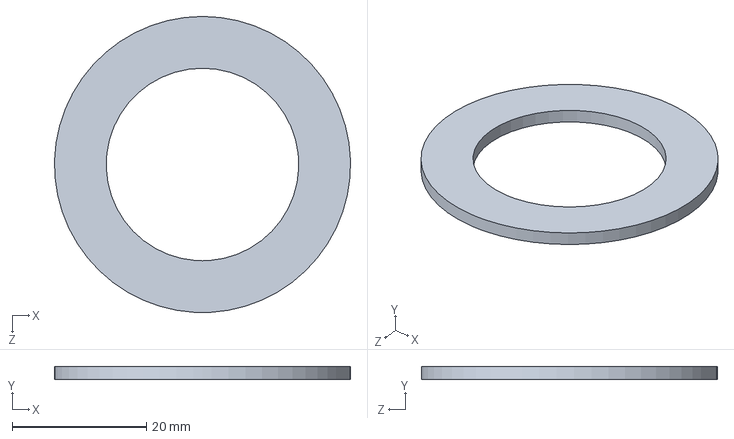
[picture p55: CAD file, 2023-10-04]
Shared CAD/Roller Bearing.SLDPRT
44.1 x 1.98 x 44.1 mm
