RHIT-steineca/Armold/Elbow and Pronation Solidworks/24 pitch 12 teeth 2.5x scale.SLDPRT

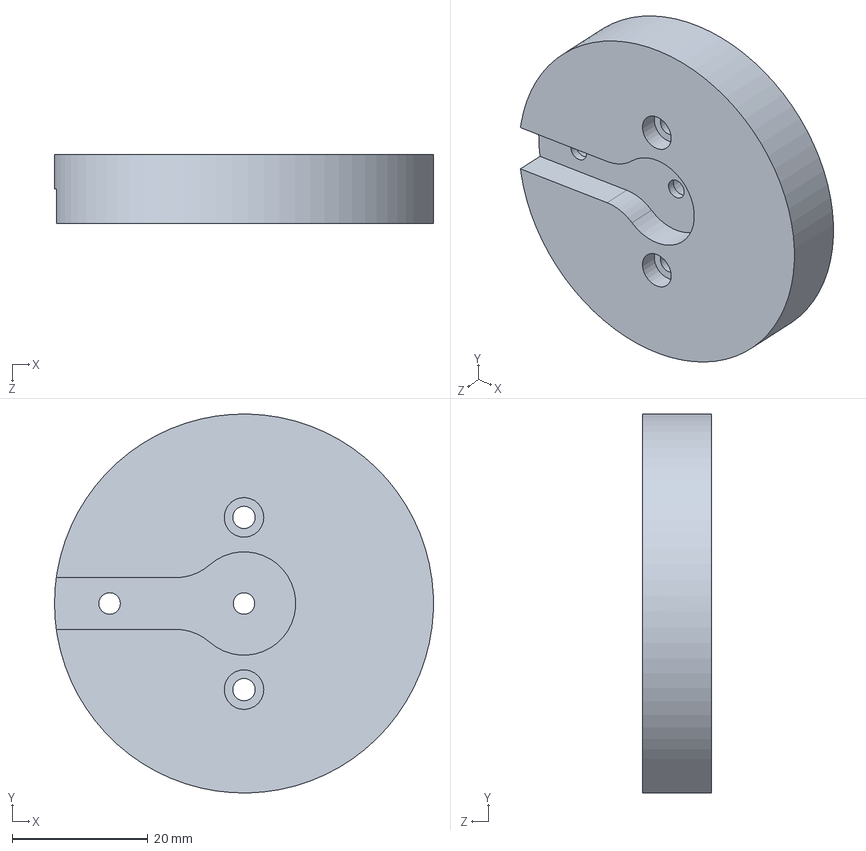
[picture p56: CAD file, 2024-03-17]
Elbow and Pronation Solidworks/24 pitch 12 teeth 2.5x scale.SLDPRT
55.9 x 55.9 x 10.2 mm
