RHIT-steineca/Armold/Shared CAD/Pitch24N24withCrankScaled.SLDPRT

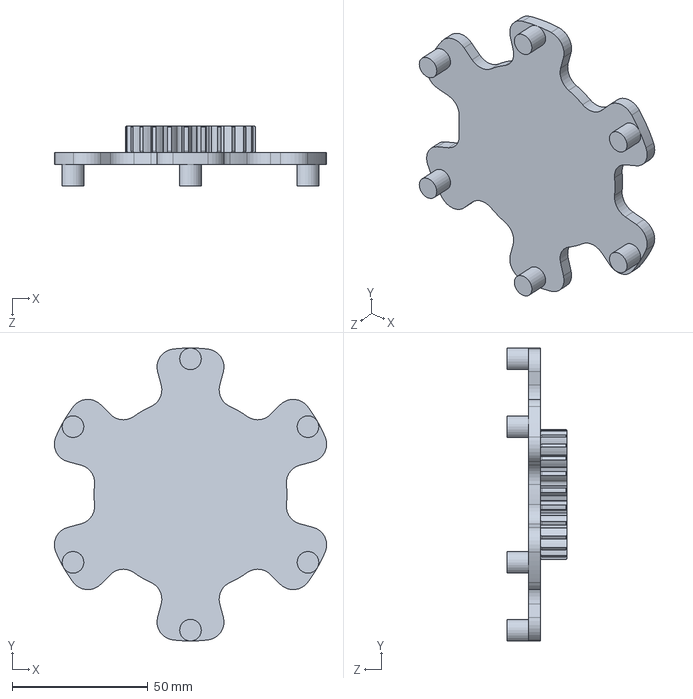
[picture p57: CAD file, 2023-10-04]
Shared CAD/Pitch24N24withCrankScaled.SLDPRT
100.4 x 108.0 x 22.2 mm
