RHIT-steineca/Armold/Elbow and Pronation Solidworks/20Kg Servo.SLDPRT

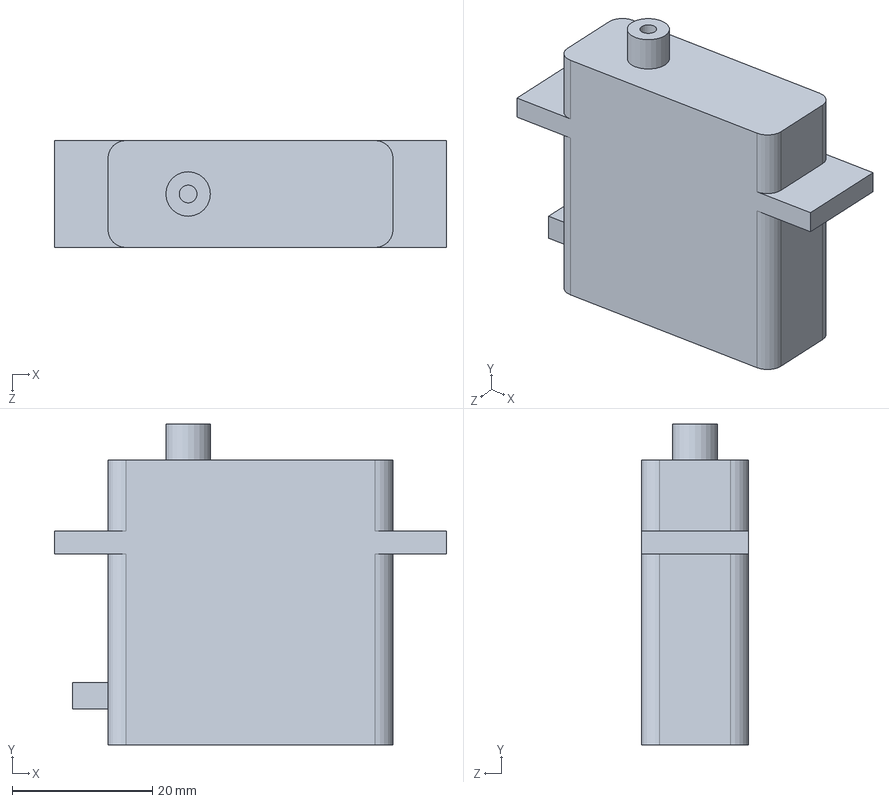
[picture p58: CAD file, 2024-03-17]
Elbow and Pronation Solidworks/20Kg Servo.SLDPRT
55.9 x 45.7 x 15.2 mm
