RHIT-steineca/Armold/Shared CAD/Crank for GR 4 V5 Scaled.SLDPRT

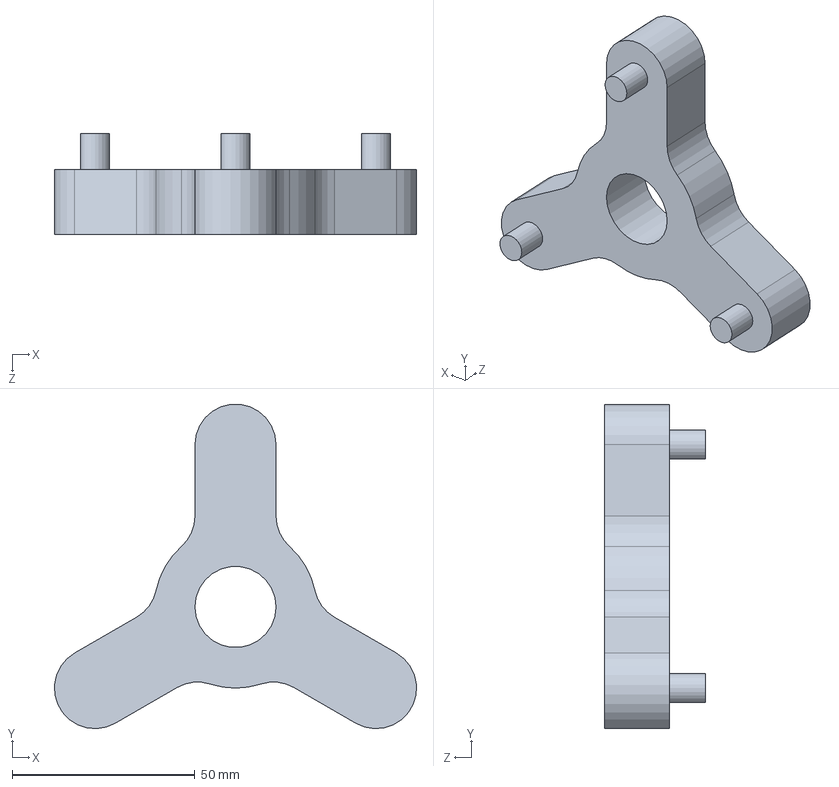
[picture p59: CAD file, 2023-10-04]
Shared CAD/Crank for GR 4 V5 Scaled.SLDPRT
99.1 x 88.8 x 27.6 mm
