RHIT-steineca/Armold/Elbow and Pronation Solidworks/elbow to forearm connection leg.SLDPRT

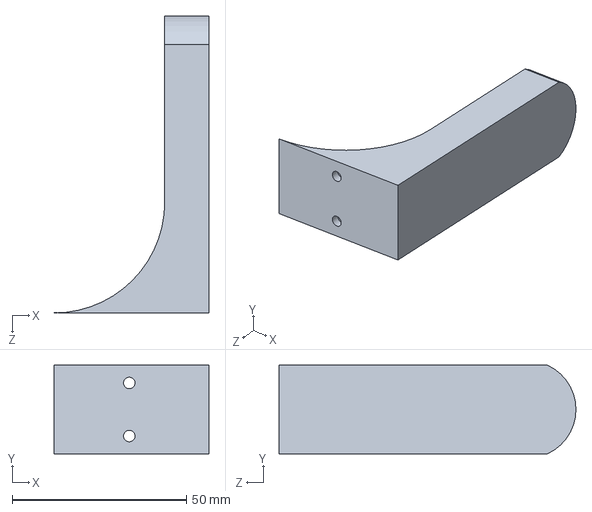
[picture p60: CAD file, 2024-03-17]
Elbow and Pronation Solidworks/elbow to forearm connection leg.SLDPRT
44.5 x 25.4 x 85.2 mm
