RHIT-steineca/Armold/Shared CAD/ThickRingPitch24N72Scale.SLDPRT

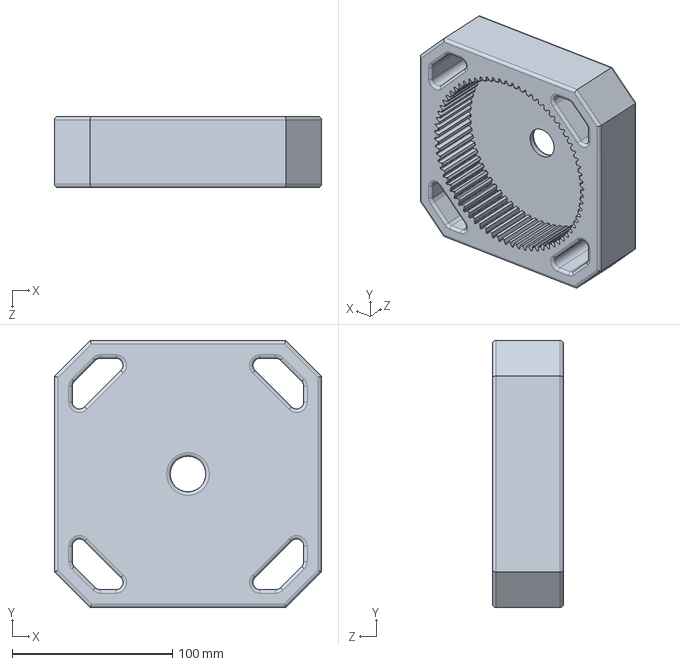
[picture p61: CAD file, 2023-10-04]
Shared CAD/ThickRingPitch24N72Scale.SLDPRT
166.7 x 166.7 x 44.5 mm
