RHIT-steineca/Armold/Elbow and Pronation Solidworks/Pronation Servo Stock.SLDPRT

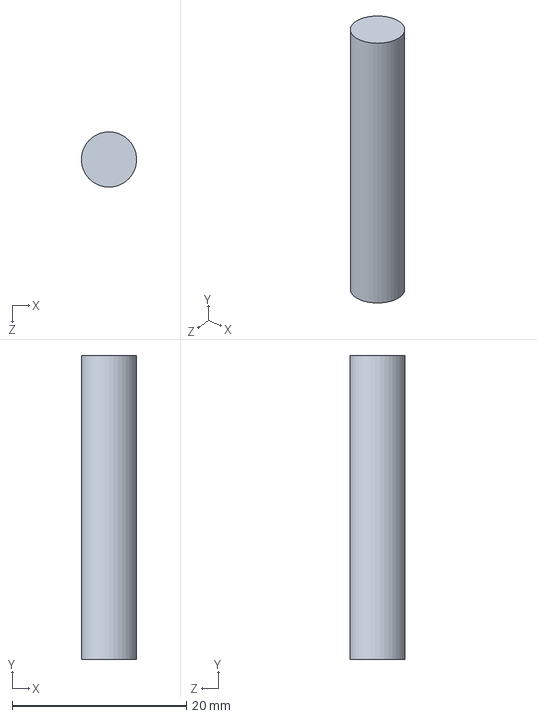
[picture p62: CAD file, 2024-03-17]
Elbow and Pronation Solidworks/Pronation Servo Stock.SLDPRT
6.33 x 34.9 x 6.35 mm
