RHIT-steineca/Armold/Shared CAD/PlanetPitch24N24V4Scaled.SLDPRT

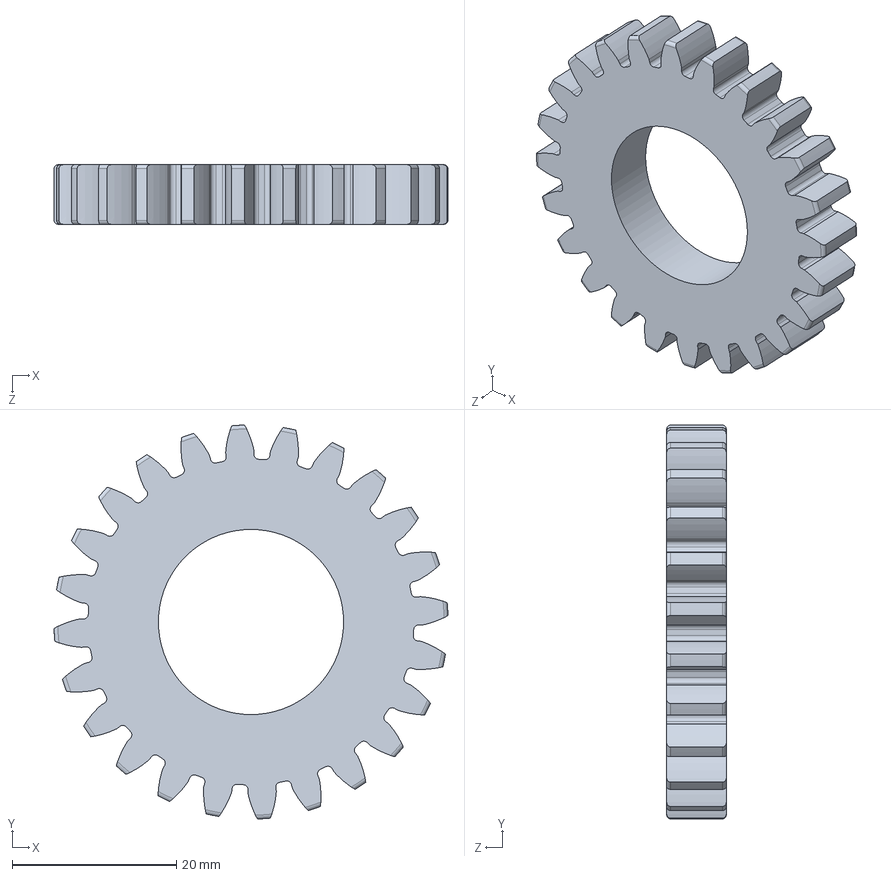
[picture p63: CAD file, 2023-10-04]
Shared CAD/PlanetPitch24N24V4Scaled.SLDPRT
48.0 x 48.0 x 7.26 mm
