RHIT-steineca/Armold/Elbow and Pronation Solidworks/Basic Roller Bearing.SLDPRT

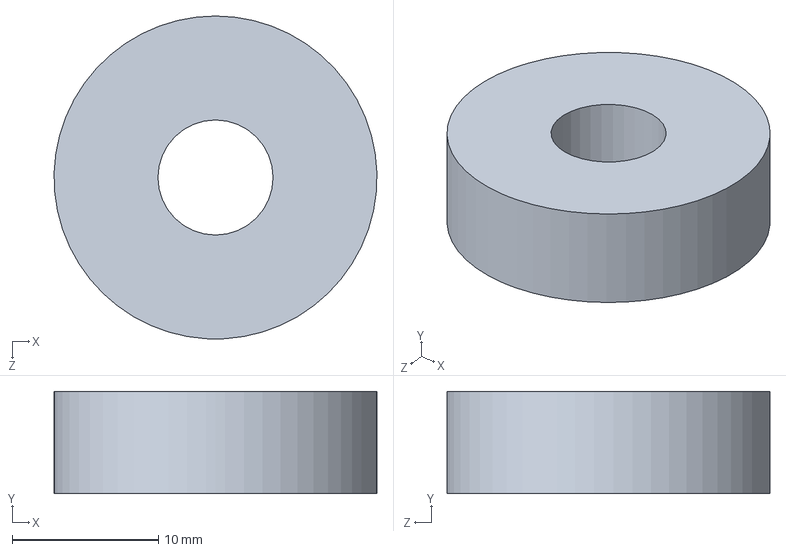
[picture p64: CAD file, 2024-03-17]
Elbow and Pronation Solidworks/Basic Roller Bearing.SLDPRT
22.1 x 6.98 x 22.1 mm
