RHIT-steineca/Armold/Shared CAD/ShoulderStepperMotor.SLDPRT

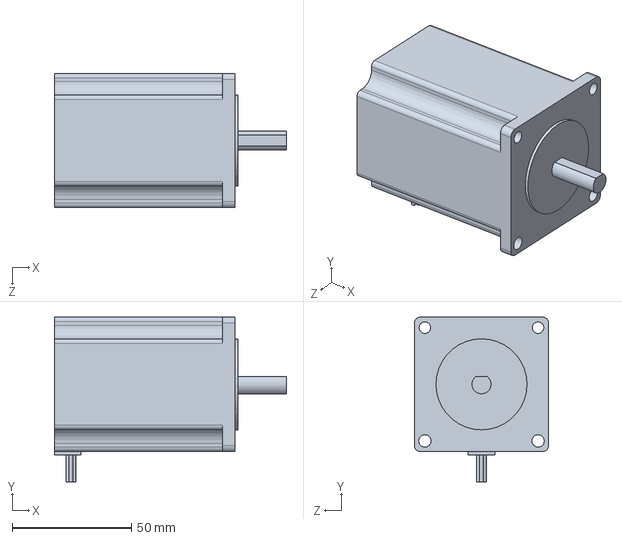
[picture p65: CAD file, 2023-10-04]
Shared CAD/ShoulderStepperMotor.SLDPRT
97.1 x 69.0 x 56.3 mm
