RHIT-steineca/Armold/Elbow and Pronation Solidworks/ServoHolderElbow.SLDPRT

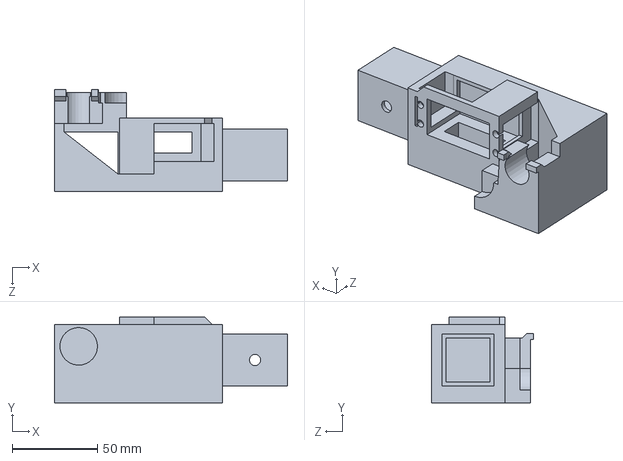
[picture p66: CAD file, 2024-03-17]
Elbow and Pronation Solidworks/ServoHolderElbow.SLDPRT
136.9 x 50.5 x 60.2 mm
