RHIT-steineca/Armold/Shared CAD/Pitch24N36V5Scaled.SLDPRT

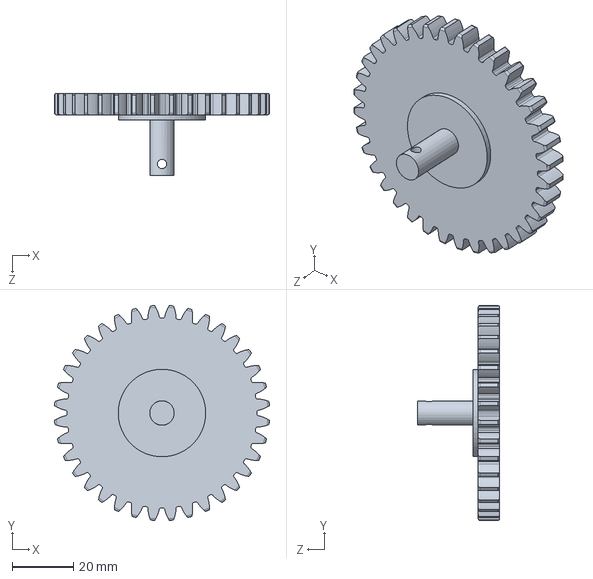
[picture p67: CAD file, 2023-10-04]
Shared CAD/Pitch24N36V5Scaled.SLDPRT
70.2 x 70.2 x 26.9 mm
