RHIT-steineca/Armold/Elbow and Pronation Solidworks/24-15 Pronation Servo Gear.SLDPRT

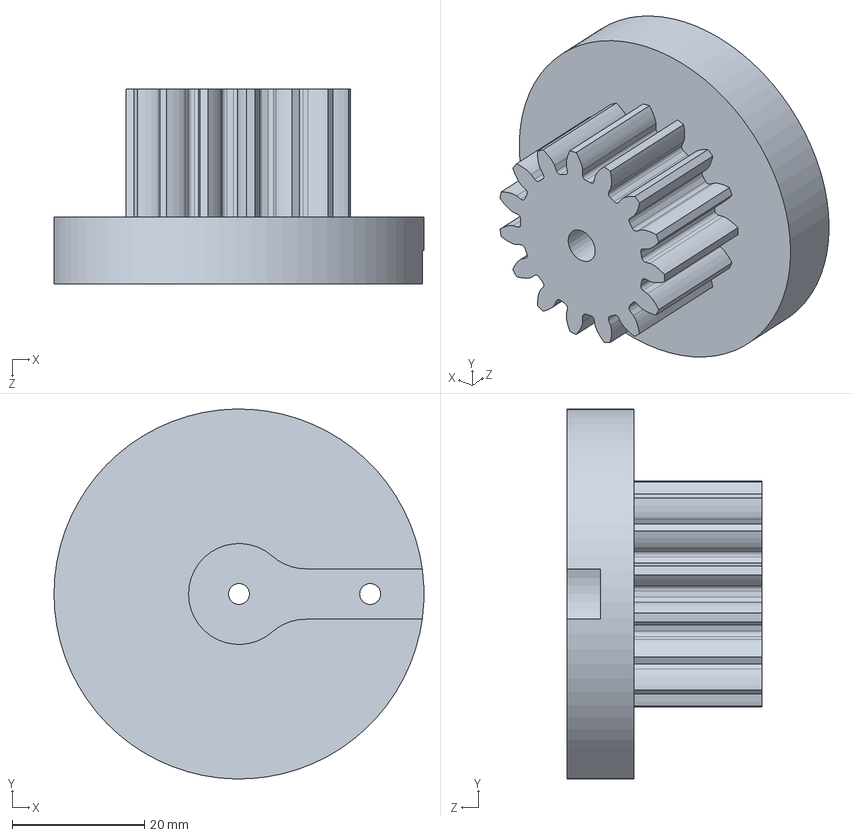
[picture p68: CAD file, 2024-03-17]
Elbow and Pronation Solidworks/24-15 Pronation Servo Gear.SLDPRT
55.9 x 55.9 x 29.5 mm
