RHIT-steineca/Armold/Shared CAD/MotorConnectorV3Scaled.SLDPRT

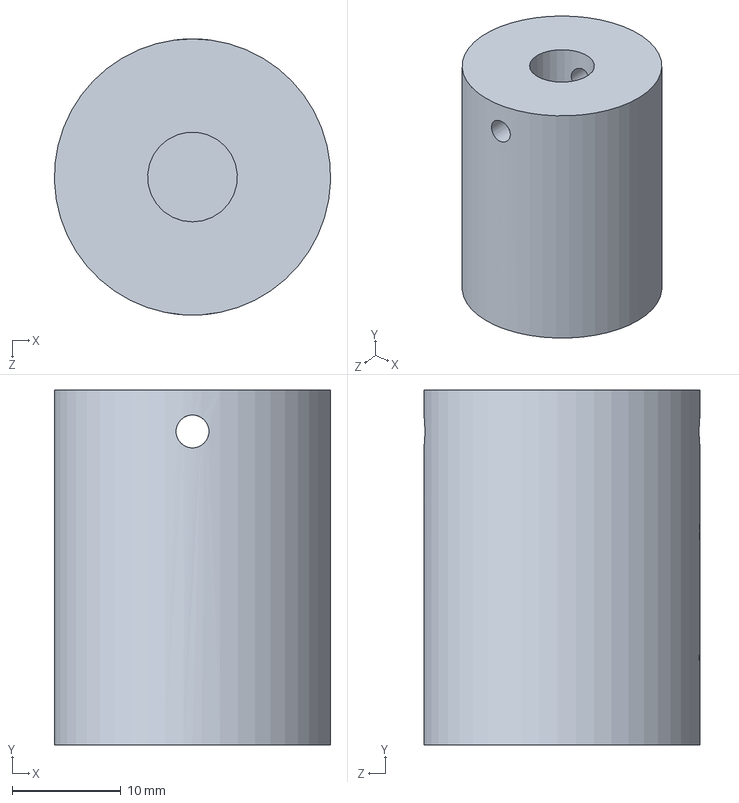
[picture p69: CAD file, 2023-10-04]
Shared CAD/MotorConnectorV3Scaled.SLDPRT
25.4 x 32.6 x 25.4 mm
