RHIT-steineca/Armold/Elbow and Pronation Solidworks/potentiometer gear connection piece.SLDPRT

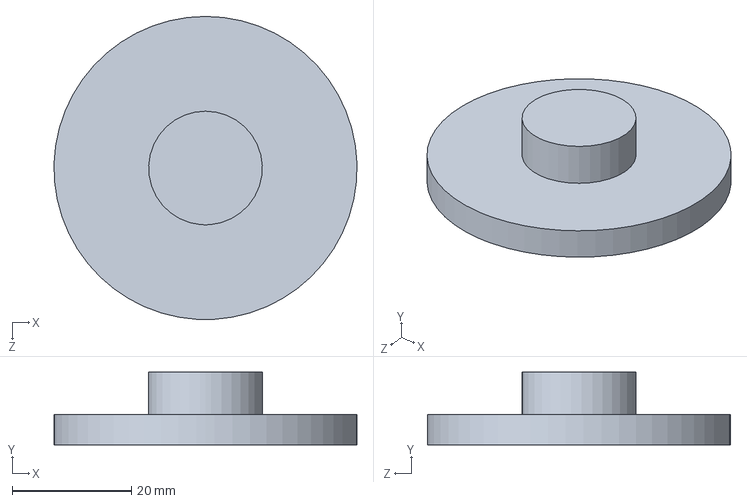
[picture p70: CAD file, 2024-01-10]
Elbow and Pronation Solidworks/potentiometer gear connection piece.SLDPRT
50.8 x 12.2 x 50.8 mm
