RHIT-steineca/Armold/Elbow and Pronation Solidworks/Needle Bearing.SLDPRT

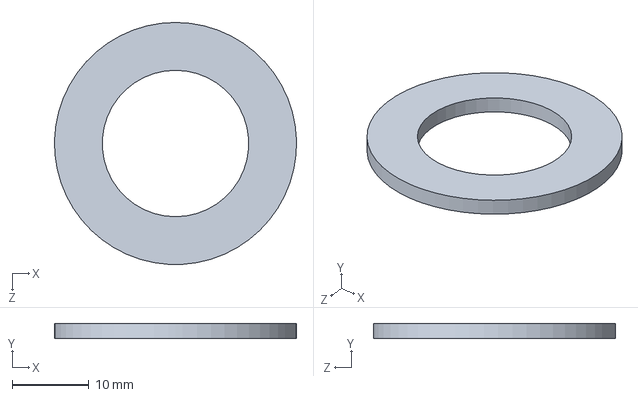
[picture p71: CAD file, 2024-01-10]
Elbow and Pronation Solidworks/Needle Bearing.SLDPRT
31.5 x 1.98 x 31.5 mm
