RHIT-steineca/Armold/Elbow and Pronation Solidworks/20KgServoMetalElbow.SLDPRT

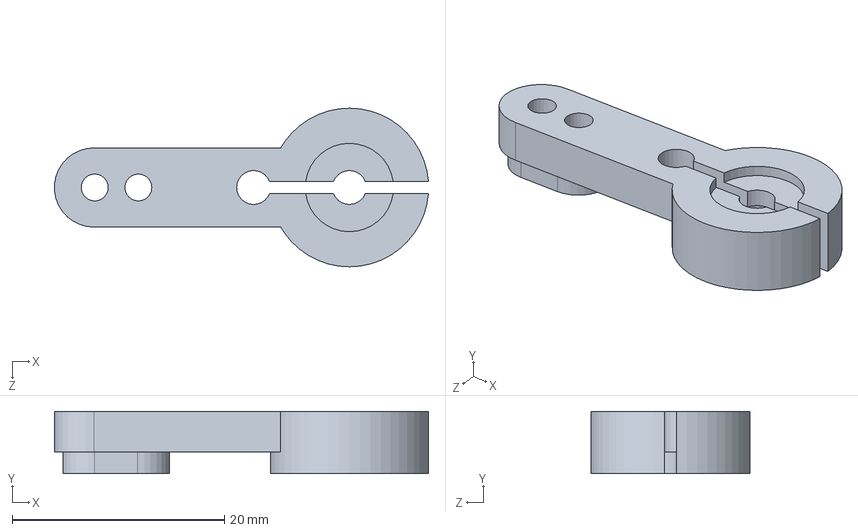
[picture p72: CAD file, 2023-11-29]
Elbow and Pronation Solidworks/20KgServoMetalElbow.SLDPRT
35.3 x 5.89 x 15.0 mm
