RHIT-steineca/Armold/Elbow and Pronation Solidworks/B10K Potentiometer.SLDPRT

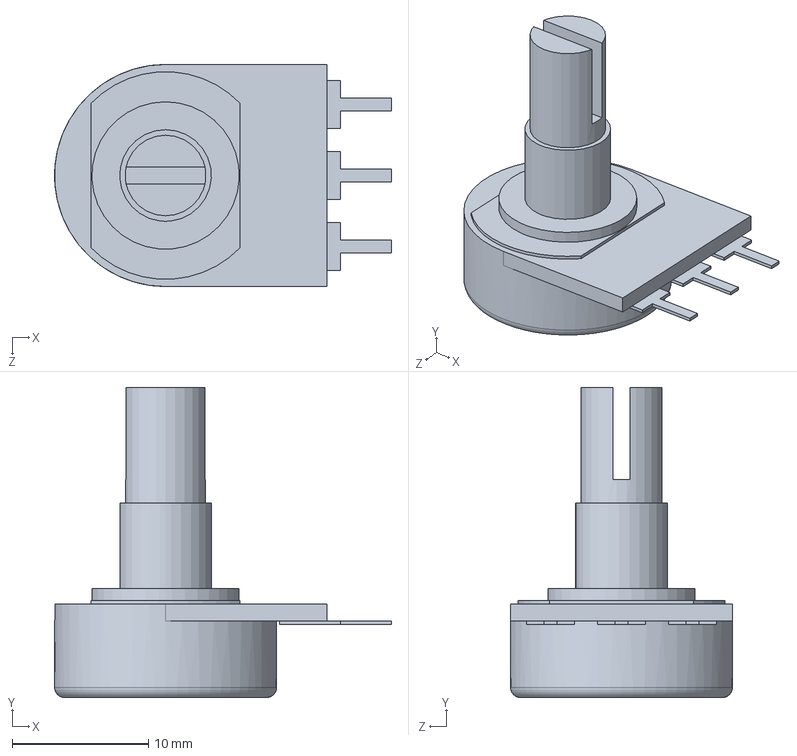
[picture p73: CAD file, 2023-11-29]
Elbow and Pronation Solidworks/B10K Potentiometer.SLDPRT
24.7 x 22.8 x 16.3 mm
