RHIT-steineca/Armold/(list of files, cad)

Other CAD files:
Elbow and Pronation Solidworks/Safety instructions.SLDPRT
Shared CAD/FidgetSpinnerBearing.SLDPRT
Elbow and Pronation Solidworks/20KgServo.SLDPRT
Elbow and Pronation Solidworks/Elbow Assembly Drawing.SLDDRW
Elbow and Pronation Solidworks/Pronation Assembly Drawing.SLDDRW
Elbow and Pronation Solidworks/Safety instructions.DXF
