RHIT-steineca/Armold/Armold Simple Block Diagram.pdf

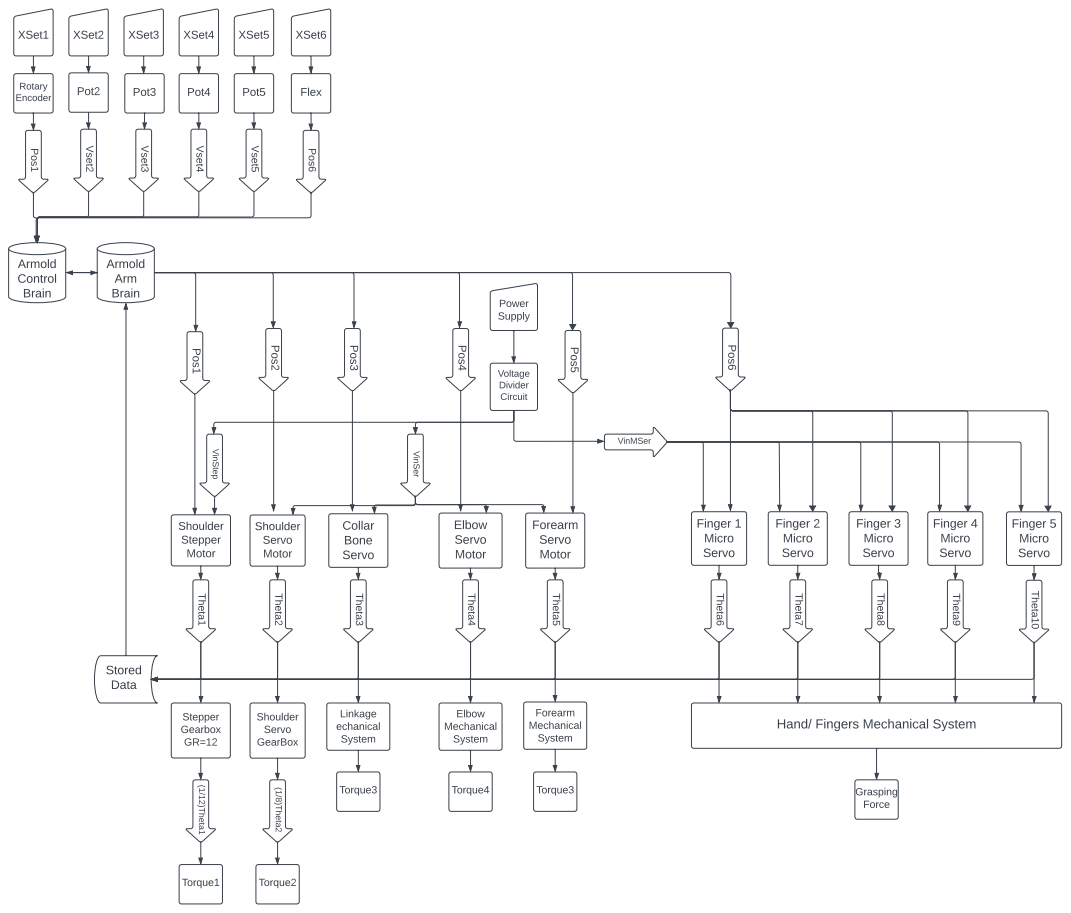
[picture p74: page 1]
Shoulder Stepper Motor; Shoulder Servo Motor; Collar Bone Servo; Stepper Gearbox GR=12; Shoulder Servo GearBox; Power Supply; Elbow Servo Motor; Forearm Servo Motor; Finger 1 Micro Servo; Finger 2 Micro Servo; Finger 3 Micro Servo; Finger 4 Micro Servo; Finger 5 Micro Servo; VinMSer; Voltage Divider Circuit; Grasping Force; Torque1; Torque2; Linkage echanical System; Elbow Mechanical System; Forearm Mechanical System; Torque3; Torque4; Armold Control Brain; Stored Data; XSet1; XSet2; XSet3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

Hand/ Fingers Mechanical System
