RHIT-steineca/Armold/Code_Files/robot.py

import os, sys, time, csv, json, math
import mqtt_helper
import pyfirmata

# set intial robot values
startVals = {"shoulderCB":0,"shoulderR":0,"shoulderLR":0,"elbow":0,"wrist":0,"fingerPTR":0,"fingerMDL":0,"fingerRNG":0,"fingerPKY":0,"fingerTHM":0}
actualVals = {"shoulderCB":0,"shoulderR":0,"shoulderLR":0,"elbow":0,"wrist":0,"fingerPTR":0,"fingerMDL":0,"fingerRNG":0,"fingerPKY":0,"fingerTHM":0}
stepperActualVals = {"shoulderR":0}
targetVals = {"shoulderCB":0,"shoulderR":0,"shoulderLR":0,"elbow":210,"wrist":0,"fingerPTR":180,"fingerMDL":180,"fingerRNG":0,"fingerPKY":0,"fingerTHM":0}
smoothingBasis = {"shoulderCB":0,"shoulderR":0,"shoulderLR":0,"elbow":0,"wrist":0,"fingerPTR":0,"fingerMDL":0,"fingerRNG":0,"fingerPKY":0,"fingerTHM":0}
# map of joints to arduino pins
pinMapping = dict()
actuatorTypes = {"shoulderCB":"25kg","shoulderR":"STEP","shoulderLR":"40kg","elbow":"40kg","wrist":"40kg","fingerPTR":"3kg","fingerMDL":"3kg","fingerRNG":"3kg","fingerPKY":"3kg","fingerTHM":"3kg"}
connections = dict()
# acceptable ranges
limitedMinDegs = {"shoulderCB":0,"shoulderR":0,"shoulderLR":0,"elbow":0,"wrist":0,"fingerPTR":0,"fingerMDL":0,"fingerRNG":0,"fingerPKY":0,"fingerTHM":0}
limitedMaxDegs = {"shoulderCB":270,"shoulderR":2000,"shoulderLR":270,"elbow":200,"wrist":230,"fingerPTR":180,"fingerMDL":160,"fingerRNG":180,"fingerPKY":180,"fingerTHM":120}
actuatorMaxRange = {"shoulderCB":270,"shoulderR":2000,"shoulderLR":270,"elbow":270,"wrist":270,"fingerPTR":180,"fingerMDL":180,"fingerRNG":180,"fingerPKY":180,"fingerTHM":180}
arduinoMinVals = {"shoulderCB":0,"shoulderR":0,"shoulderLR":0,"elbow":0,"wrist":0,"fingerPTR":0,"fingerMDL":0,"fingerRNG":0,"fingerPKY":0,"fingerTHM":0}
arduinoMaxVals = {"shoulderCB":180,"shoulderR":180,"shoulderLR":180,"elbow":180, "wrist":180,"fingerPTR":180,"fingerMDL":180,"fingerRNG":180,"fingerPKY":180,"fingerTHM":180}

# initialization
board = pyfirmata.ArduinoMega('/dev/ttyACM0')
it = pyfirmata.util.Iterator(board)
it.start()
print("Arduino connection successfully started")
valPath = "//home//pi//"
fullValPath = os.path.join(valPath, "robovals.txt")
fullStepPath = os.path.join(valPath, "stepperPos.txt")
pinsPath = os.path.join(valPath, "Armold//Code_Files//pins.txt")
with open(pinsPath, "r") as pinFile:
    pinFile.readline()
    pinFile.readline()
    pinFile.readline()
    pinMapping = json.loads(pinFile.readline())
frameKey = "init"
frameLen = 1.0
lastFrame = time.time()
time.sleep(1)
try:
    with open(fullStepPath, "r") as stepFile:
        reader = csv.reader(stepFile)
        stepperActualVals = json.loads(stepFile.readline())
except:
    with open(fullStepPath, "w") as stepFile:
        actualValString = str(stepperActualVals).replace("'", '"')
        stepFile.write(f"{actualValString}")

# map actuator connections
for name, pin in pinMapping.items():
    actuatorType = actuatorTypes[name]
    # Stepper Motor
    if(actuatorType == "STEP"):
        stepperConnections = dict()
        stepperConnections["step"] = board.get_pin(f'd:{pin}:o')
        stepperConnections["direction"] = board.get_pin(f'd:{pin - 1}:o')
        stepperConnections["step"].write(0)
        stepperConnections["direction"].write(0)
        connections[name] = stepperConnections
    # 9g micro servos (180°)
    elif(actuatorType == "9g"):
        connections[name] = board.get_pin(f'd:{pin}:s')
        board.servo_config(pin, 500, 2430, 0)
    # 3kg small servos (180°)
    elif(actuatorType == "3kg"):
        connections[name] = board.get_pin(f'd:{pin}:s')
        board.servo_config(pin, 500, 1000, 0)
    # 20kg medium servos (270°)
    elif(actuatorType == "20kg"):
        connections[name] = board.get_pin(f'd:{pin}:s')
        board.servo_config(pin, 500, 2470, 0)
    # 25kg medium servos (270°)
    elif(actuatorType == "25kg"):
        connections[name] = board.get_pin(f'd:{pin}:s')
        board.servo_config(pin, 500, 2490, 0)
    # 40kg medium servos (270°)
    elif(actuatorType == "40kg"):
        connections[name] = board.get_pin(f'd:{pin}:s')
        board.servo_config(pin, 500, 2520, 0)
    # unmapped actuators
    else:
        connections[name] = board.get_pin(f'd:{pin}:s')
        board.servo_config(pin, 500, 2500, 0)

def moveArduino():
    for name, pin in pinMapping.items():
        if(actuatorTypes[name] == "STEP"):
            stepperConnections = connections[name]
            stepperDeltaPos = actualVals[name] - stepperActualVals[name]
            stepperDirection = -1
            stepperConnections["direction"].write(0)
            if(stepperDeltaPos > 0):
                stepperDirection = 1
                stepperConnections["direction"].write(1)
            print(f"Taking {stepperDeltaPos} steps")
            for i in range(math.floor(abs(stepperDeltaPos))):
                time.sleep(0.00001)
                stepperConnections["step"].write(1)
                time.sleep(0.00001)
                stepperConnections["step"].write(0)
                stepperActualVals[name] += stepperDirection
                with open(fullStepPath, "w") as stepFile:
                    actualValString = str(stepperActualVals).replace("'", '"')
                    stepFile.write(f"{actualValString}")
        else: 
            connection = connections[name]
            newVal = convertAngleToVal(name, actualVals[name])
            print(f"Moving {name} to {newVal}")
            connection.write(newVal)

def convertAngleToVal(actuatorName, sensorAngle):
    minVal = arduinoMinVals[actuatorName]
    maxVal = arduinoMaxVals[actuatorName]
    minDeg = limitedMinDegs[actuatorName]
    maxDeg = actuatorMaxRange[actuatorName]
    valRange = maxVal-minVal
    degRange = maxDeg-minDeg
    calcVal = sensorAngle * valRange / degRange
    return round(calcVal)

class Connection:
    def __init__(connection):
        connection.client = mqtt_helper.MqttClient()
        connection.setup()
        
    def setup(connection):
        connection.client.callback = lambda type, payload: connection.mqtt_callback(type, payload)
        connection.client.connect("Armold/ToBrain", "Armold/ToDummy", use_off_campus_broker=False)
    
    def mqtt_callback(connection, type_name, payload):
        print("\nNEW DATA\n")
        try:
            with open(fullValPath, "w") as valFile:
                valstring = f"{str(payload[0])}\n{str(payload[1])}"
                if("RESET" not in str(valstring)):
                    for jointName, jointVal in payload[2].items():
                        valstring += f'\n"{jointName}",{jointVal}'
                valFile.write(f"{valstring}")
                print("\nNEW DATA\n")
        except Exception as error:
            raise error

connection = Connection()
print("Communication successfully established")

# main loop
while True:
    try:
        # checking for new target values assigned
        connection.client.client.loop()
        with open(fullValPath, "r") as valFile:
            try:
                keyLine = valFile.readline()
                rateLine = valFile.readline()
                if("RESET" in str(rateLine)):
                    for name, val in stepperActualVals.items():
                        stepperActualVals[name] = 0
                    with open(fullStepPath, "w") as stepFile:
                        actualValString = str(stepperActualVals).replace("'", '"')
                        stepFile.write(f"{actualValString}")
                    raise Exception("RESET")
                if (keyLine != frameKey and keyLine != ""):
                    frameKey = keyLine
                    refreshRate = float(rateLine)
                    frameLen = 1.0 / refreshRate
                    reader = csv.reader(valFile)
                    for row in reader:
                        jointName = row[0]
                        jointVal = float(row[1])
                        if jointName in pinMapping.keys():
                            startVals[jointName] = targetVals[jointName]
                            actualVals[jointName] = targetVals[jointName]
                            if (abs(jointVal - targetVals[jointName]) >= smoothingBasis[jointName]):
                                targetVals[jointName] = jointVal
                    lastFrame = time.time()
            except Exception as error:
                print(error)
                continue
        # check for time passed since new frame and interpolate value
        framePercent = (time.time() - lastFrame) / frameLen
        for joint, actualVal in actualVals.items():
            # check to interpolate if within frame duration
            if (framePercent >= 1 or actualVals[joint] == targetVals[joint]):
                interpolated = targetVals[joint]
            else:
                startVal = startVals[joint]
                targetVal = targetVals[joint]
                deltaVal = targetVal - startVal
                deltaInterpolated = deltaVal * framePercent
                interpolated = startVal + deltaInterpolated
            # ensure value is within acceptable range
            if(interpolated < limitedMinDegs[joint]):
                interpolated = limitedMinDegs[joint]
            elif(interpolated > limitedMaxDegs[joint]):
                interpolated = limitedMaxDegs[joint]
            actualVals[joint] = interpolated
        moveArduino()
    except Exception as error:
        connection.client.client.reinitialise()
        connection.setup()
        print(error)
