RHIT-steineca/Armold/(commit log)

2023-09-13 Wrist P1 STL
    [Wrist Form 1.STL]
2023-09-13 9.13 STLS
    [Elbow Form 1.STL, Wrist Form 2.STL]
2023-09-17 re-organizing directory
    [Elbow Form 1.STL, Wrist Form 1.STL, Wrist Form 2.STL]
2023-09-28 pin stuff
2023-10-01 dont print success
2023-10-01 adding ring finger CAD files
    [assembly (extended & closed configuration).SLDASM, assembly (extended and closed).SLDASM, knuckle 1, base.SLDPRT, knuckle 2, middle.SLDPRT, knuckle 2, top.SLDPRT]
2023-10-01 lotsa servo work
2023-10-04 Upload Begging of Shared CAD
    [Crank for GR 4 V5 Scaled.SLDPRT, FidgetSpinnerBearing.SLDPRT, MainAssemblyRev0DAD.SLDASM, MotorConnectorV3Scaled.SLDPRT, Pitch24N24withCrankScaled.SLDPRT, Pitch24N36V5Scaled.SLDPRT, PlanetPitch24N18V4Scaled.SLDPRT, PlanetPitch24N24V4Scaled.SLDPRT]
2023-10-04 Servo Motor Model
    [20KgServo.SLDPRT]
2023-10-04 Put Servo in Folder
    [20KgServo.SLDPRT]
2023-10-25 fix loop case
2023-10-25 added feedback to pin testing
2023-11-01 testing code updated for sensor values
2023-12-14 start each new frame at target old
2023-12-20 create frame keys to check for new frames
2023-12-20 fixed framekey generation
2023-12-20 fix framekey copy
2023-12-20 discovered and entered framerate limit
2023-12-20 start arduino code
2023-12-20 arduino basics
2023-12-20 found arduino serial
2024-01-10 move arduino code
2024-01-14 created independent arduino testing code
2024-01-17 got servos closer to working
2024-01-24 all servos mapped
2024-01-28 done with sensor setup
2024-01-29 update error testing; everything works!
    [armold.py, robot.py]
2024-01-29 drop frame notice
2024-01-31 fix floating point in recording file
    [armold.py]
2024-01-31 restricting fingers
2024-01-31 added finger restriction commented
2024-02-04 setup convertion for backwards fingers
2024-02-04 rename fingers
2024-02-05 pin mappings
2024-02-05 update servo ranges
2024-02-07 finger map
2024-02-07 added stepper motor controls
2024-02-07 stepper tracking implemented
2024-02-07 added reset code for steppers
    [armold.py, robot.py]
2024-02-09 removed prints in helper
2024-02-09 better pin mapping updater
2024-02-13 pin map
2024-03-10 stepper test code
2024-03-17 testing stepper
2024-03-17 stepper test
2024-03-17 stepper works!!!
2024-03-31 new ring pin
2024-04-15 update finger dir
2024-04-15 update finger ranges
2024-04-17 updates to GUI and fix zeroing code
    [armoldGUI.py, robot.py]
2024-04-24 no reboot for testing
    [armold.py]
2024-04-24 reminder comment to reboot on program close
    [armold.py]
2024-04-29 invert elbow and shoulder
    [armold.py]
2024-04-29 current recordings
2024-05-18 adding control panel files
    [perfboard holder.SLDPRT, top gear connection.SLDPRT]
